Kgo222/ClassroomClarity/README.md

# ClassroomClarity
This project aims to provide portable support for teachers through a central hub that displays student questions submitted through an app while also providing visual queues to inform on student engagement. Our goal is to improve lecture quality for both the students and the teachers by also including a tactile queue for the professor to notify a question as been asked.

Team Members:
- Maddie Donku
- Kaitlin Gowens
- Jesse Gruber

Project Notes are found in the _Notebook_ folder under the _main_ branch.
# Final Design Information
## Physical Design
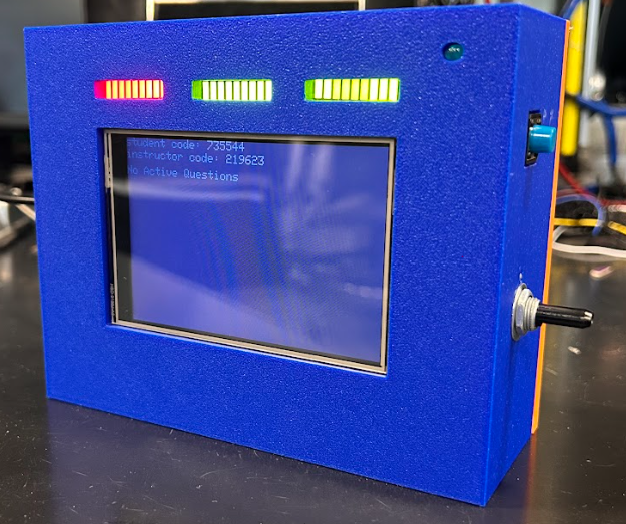
[picture p1: notebooks/kaitlin/finalResults/HubPicture.png]


## Internal Subcircuits
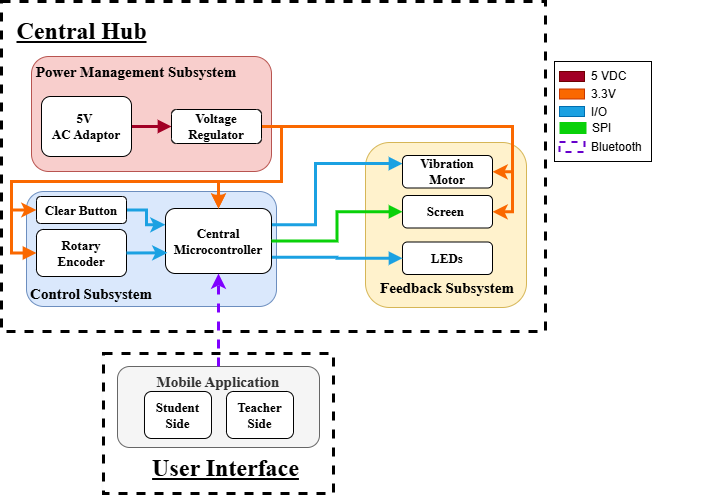
[picture p2: notebooks/kaitlin/finalResults/final_BlockDiagram.png]


## App Layout
### Student
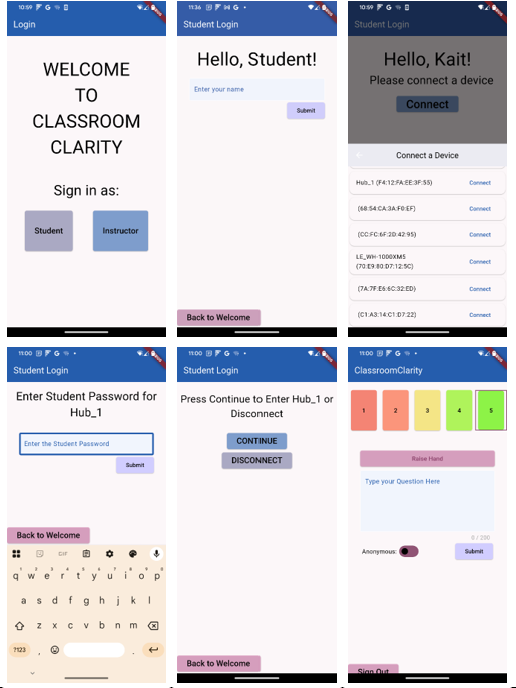
[picture p3: notebooks/kaitlin/finalResults/StudentAppLayout.png]


### Instructor
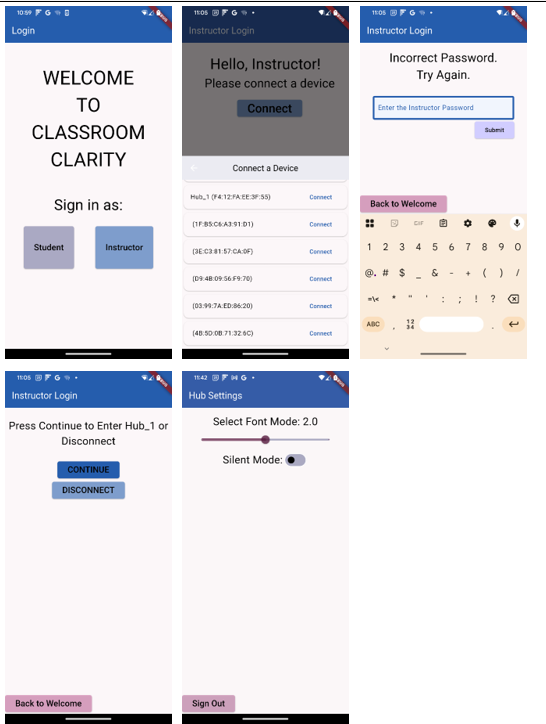
[picture p4: notebooks/kaitlin/finalResults/InstructorAppLayout.png]
