Kgo222/ClassroomClarity/boards/README.md

This folder holds the files concerning PCB design
