Kgo222/ClassroomClarity/notebooks/team/445_initial_brainstorming.pdf

## ece445 lab notebook

# brainstorming

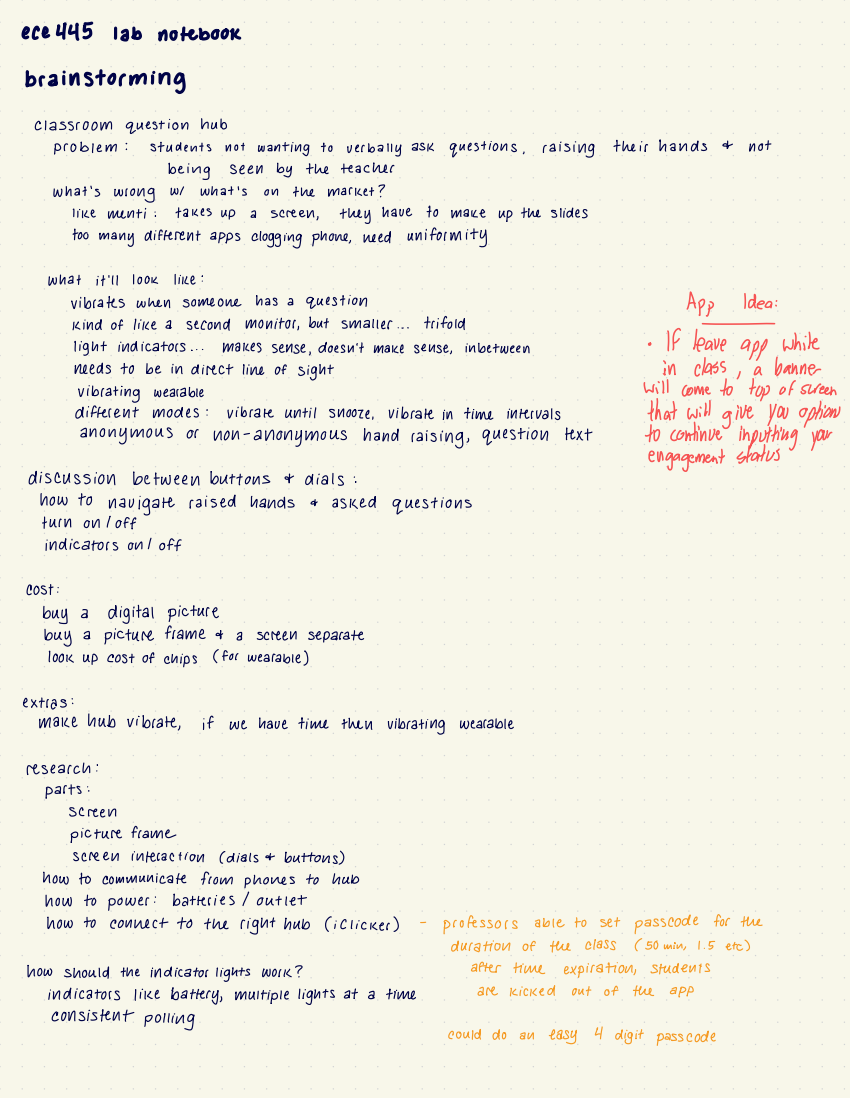
[picture p44: page 1]
classroom; question hub; problem :; students; not; wanting to; verbally ask; questions ,; raising their hands &; being seen; by the teacher; what's wrong we; what's; the; market ?; like; menti :; takes up; screen ,; they have; to make; up the slides; too many different apps clogging phone,; need; uniformity; what; look; like :; vibrates when someone; has a; question; App Idea:; kind of like a; second; monitor,; but smaller ...; trifold; e while light indicators...; makes sense ,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

discussion between buttons & dials :
t un on 1 off
indicators on 1 off

look up cost of chips (for wearable)

how to power: batteries / outlet

Research | Questions
① Bluetooth -> by we | are | making own | microcontroller, | it must

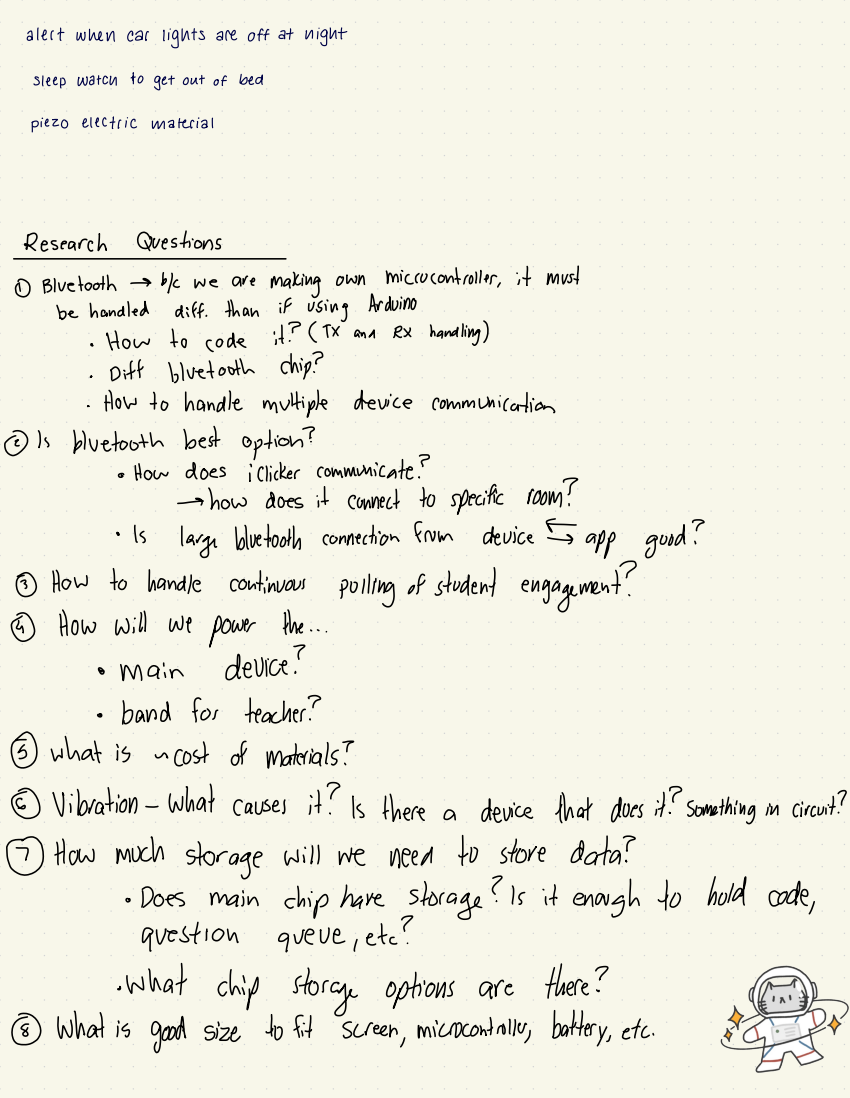
[picture p45: page 2]
alert when car; lights are off at night; sleep watch; to get out of bed; be handled; diff. than if using Ardrino; How to code; it. ? (TX and; handling); bluetooth best option?; How does; iClicker communicate ?; large bluetooth connection from; device to; app good ?; ② How to handle continuous; polling of student engagement?; main; device ?; ⑤ what is; -cost of materials ?; ② Vibration -; what causes; it ? Is there a; device that does it? something in circuit?; & How much storage will we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

piezo electric material

· Diff bluetooth chip?
How to handle multiple device communication

->how does it connect to specific room?

& How will we power the ..

· band for teacher?

I

YA

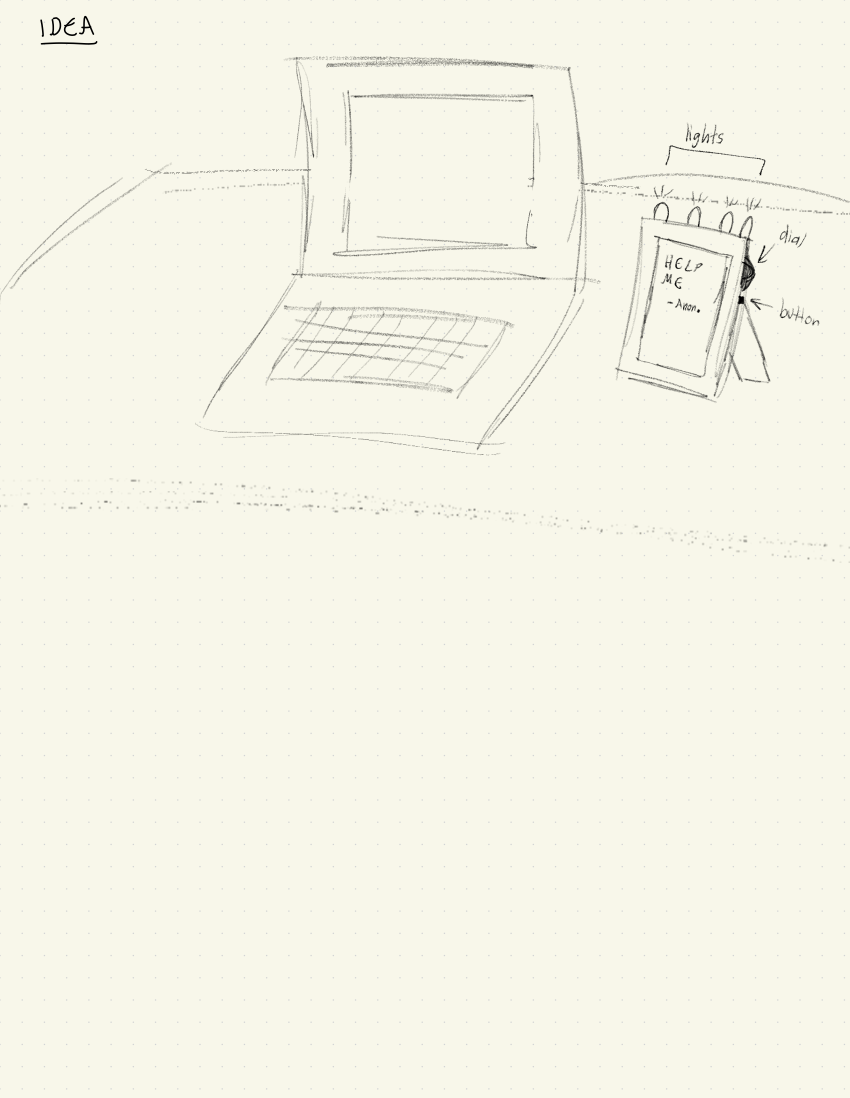
[picture p46: page 3]
