Kgo222/ClassroomClarity/notebooks/jesse/week_of_4_6_2025/445_WO_4_6_2025.pdf

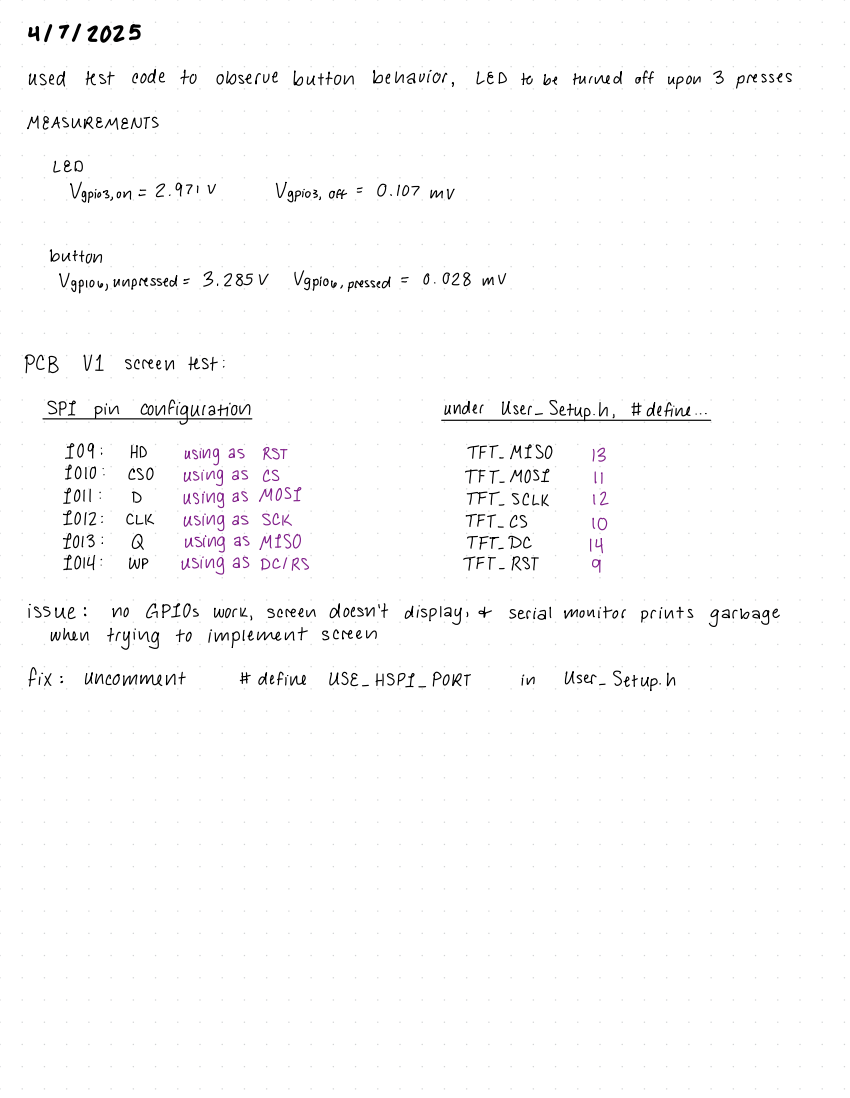
[picture p47: page 1]
used; test code to; observe button behavior ,; LED to be; turned off upon 3 presses; MEASUREMENTS; LED; Vapios, on =; Vapios,; off =; button; Vypion, unpressed =; Vypion ,; pressed =; PCB; screen; test :; SP1 pin; configuration; under; User-Setup.; #define....; using as; RST; TFT_; CSO; MOSI; using as MOSI; SCLK; CLK; SCK; TFT-; using as MISO; using as DC/RS; TFT-RST; issue :; GP10s work ,; doesn't display ,; serial monitor prints garbage; when; trying to; implement screen; fix :; Uncomment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

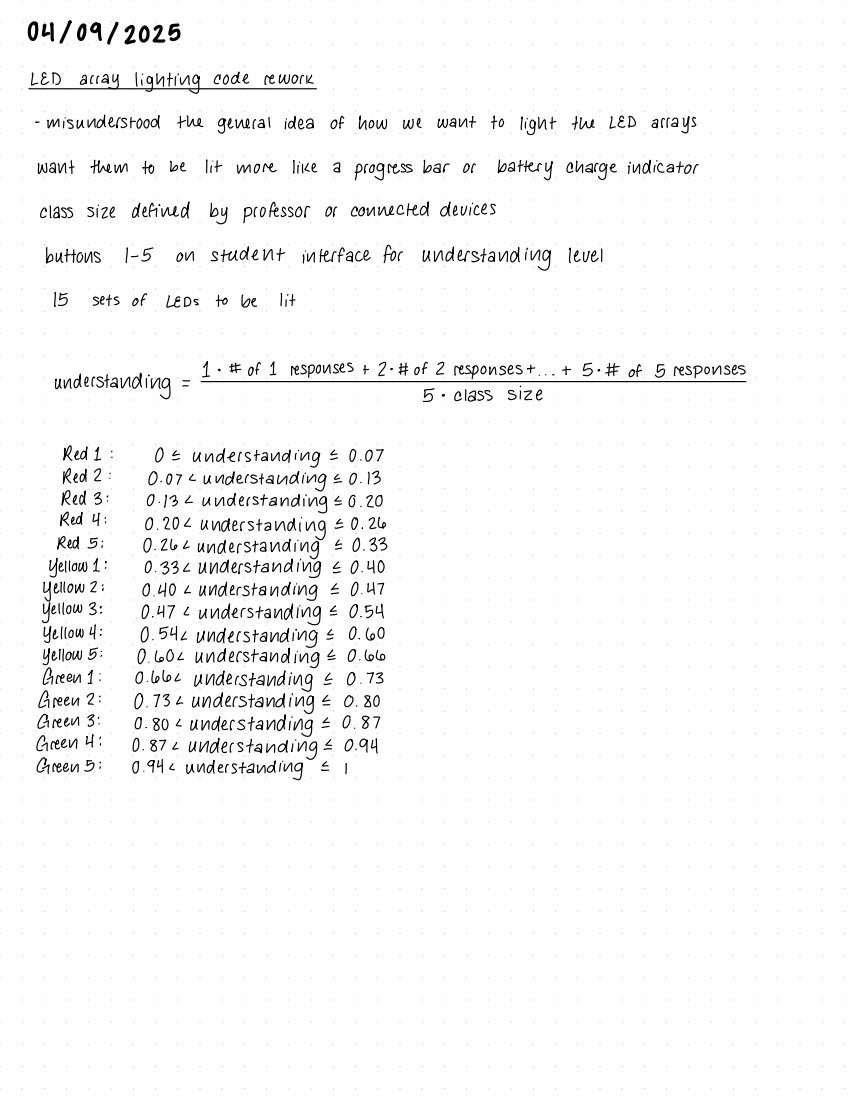
[picture p48: page 2]
LED; array lighting code rework; -misunderstood the general idea of how we; want to light the LED arrays; want them to be; lit more; like a; progress bar or; battery charge indicator; class size defined by professor or; connected devices; buttons; student interface for understanding level; sets of; LEDs; lit; # of 1 responses + 2 ·; # of 2 responses +... +; # of 5 responses; understanding =; class size; Red 1 :; understanding = 0 .; Red 2 :; 07 understanding = 0 .; Red 3 :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

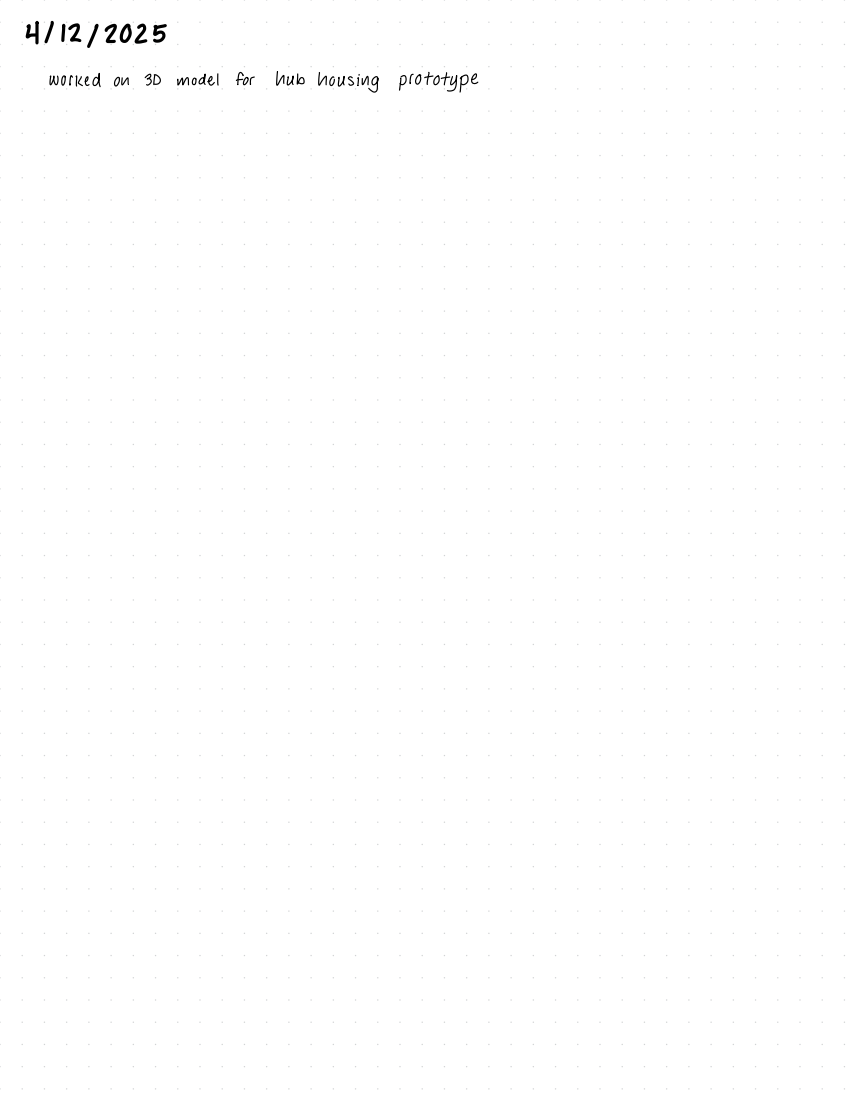
[picture p49: page 3]
worked on; model; for; hub housing prototype
