Kgo222/ClassroomClarity/notebooks/jesse/week_of_3_30_2025/445_WO_3_30_2025.pdf

processing for class | understanding data to | LEDs

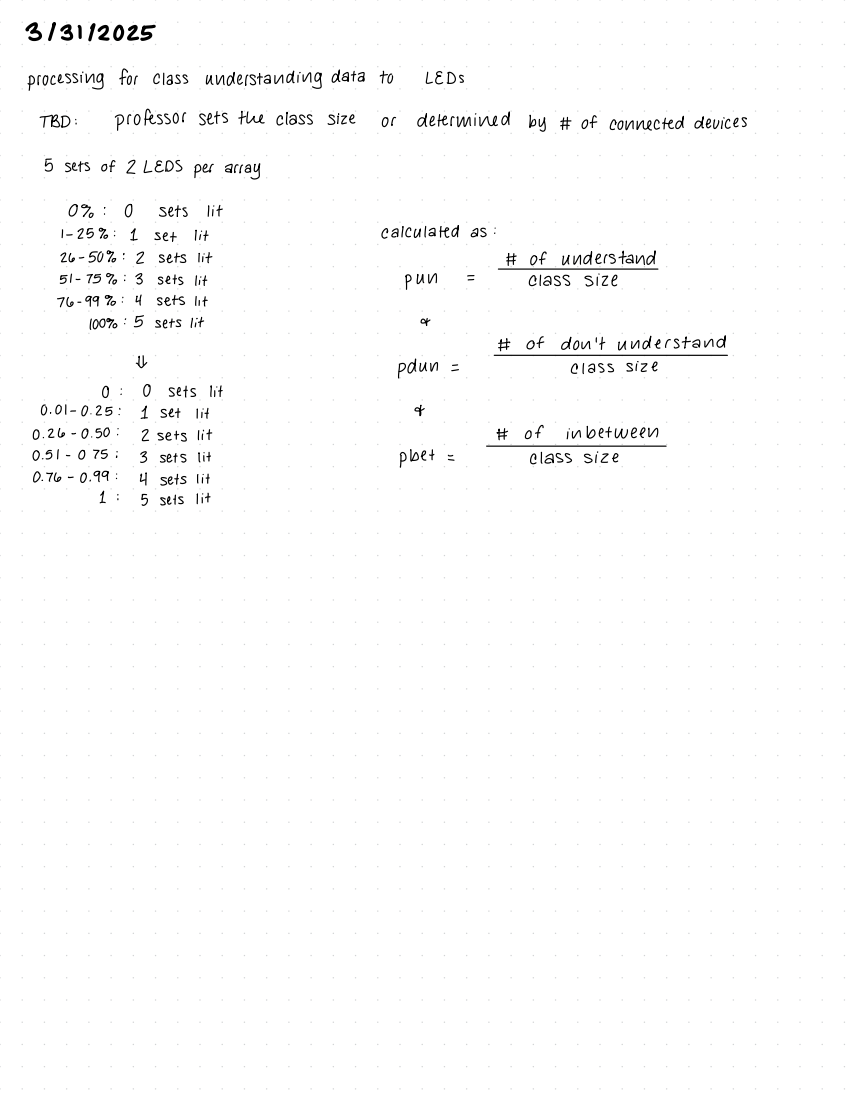
[picture p50: page 1]
TBD :; professor sets the class size; determined by # of connected devices; Sets; lit; calculated as : 1-25 %:; set; 26-50 %: I sets lit; # of understand; sets lit; pun; class size; 100%: 5 sets lit; don't understand; poun =; Class size; Sets lit; 1 set; I sets lit; inbetween; 3 sets; plet =; 4 sets lit; 5 sets lit

5 Sets of 2 LEDS per array

We | successfully communicated | with the | chip

## used the programming buttons

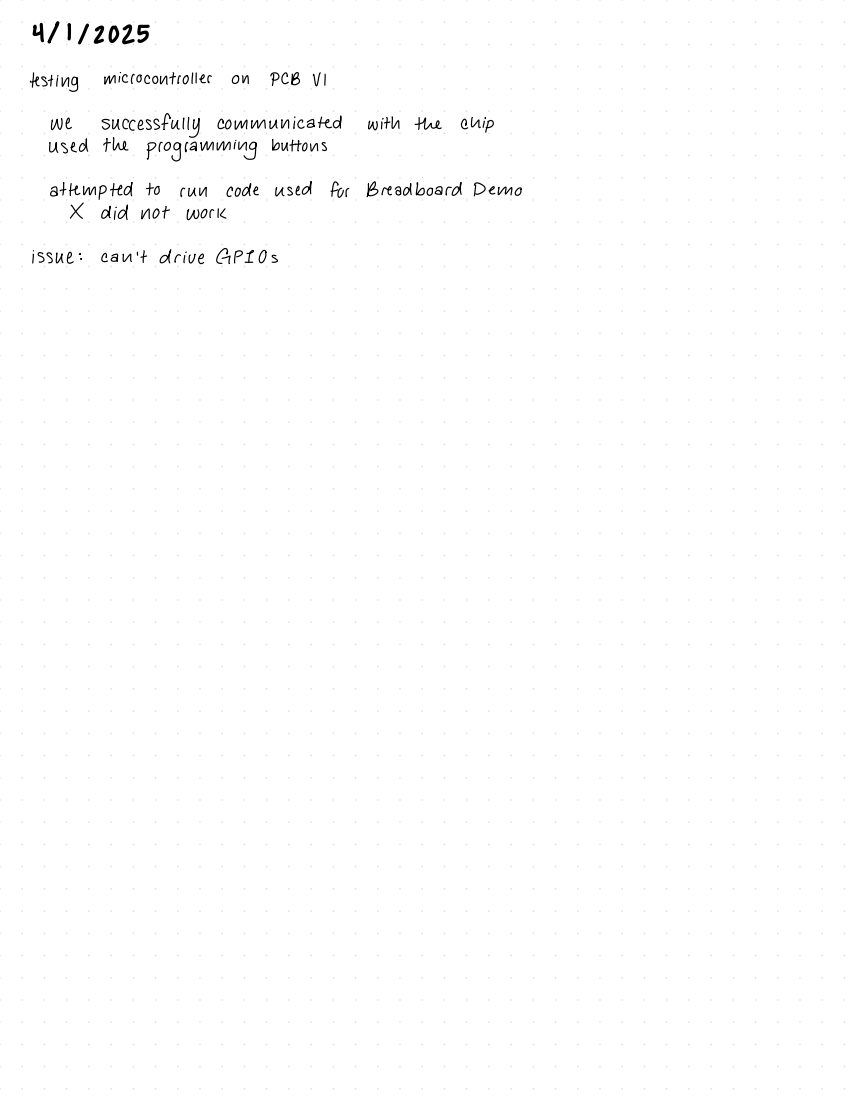
[picture p51: page 2]
testing; microcontroller; PCB VI; attempted to; run; code used for Breadboard Demo; issue :; can't drive GPIOs

X did not work

## testing w/ PCB VI

### esolved GPIO driving issue :

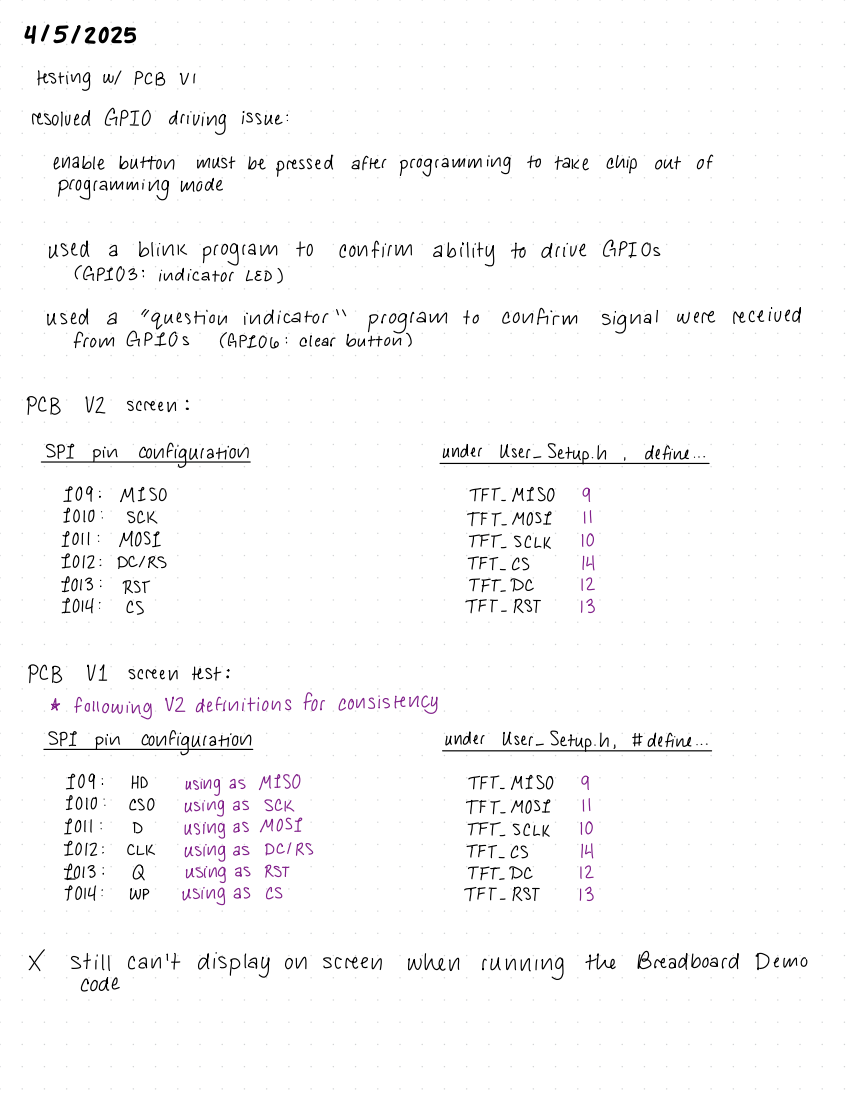
[picture p52: page 3]
enable button; must be pressed after programming to take chip out of; programming mode; used a; blink program to; confirm ability to drive GPIOs; CGP103 :; indicator LED); "question indicator"; program to; confirm; signal were; received; from GPIOs; clear button (; PCB; VI screen :; SP1 pin; configuration; under; User-Setup.; define....; MISO; TFT_; SCK; MOSI; SCLK; TFT-; RST; TFT-RST; screen; test :; #define....; using as; CSO; a using as; using as MOSI; CLK; X still can't display on; when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

* following V2 definitions for consistency
