Kgo222/ClassroomClarity/notebooks/jesse/week_of_3_23_2025/445_WO_3_23_2025.pdf

3/23/2025

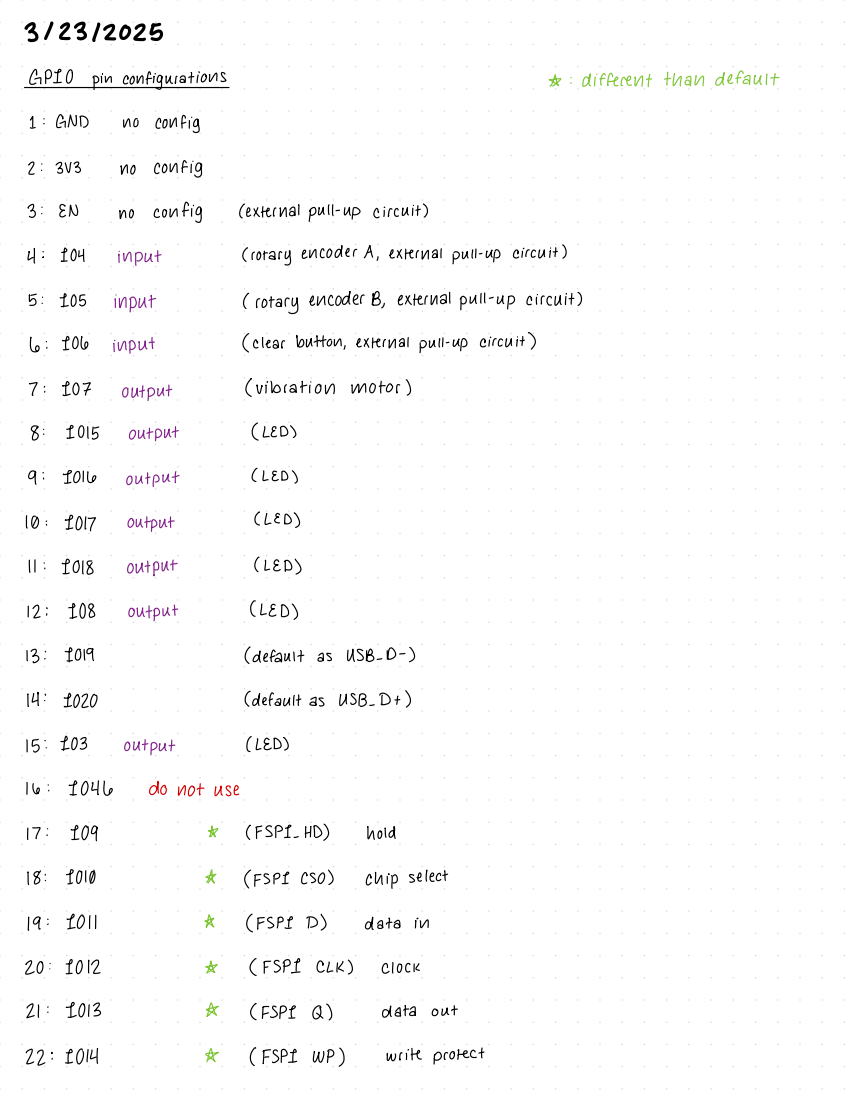
[picture p53: page 1]
GPIO pin configurations; *: different than default; GND; config; (external pull-up circuit); Crotary encoder A ,; external pull-up circuit 4 :; input; (rotary encoder B,; external pull-up circuit; (clear button,; external pull-up circuit) input; (vibration motor) output; output; (LED); (default as; USB-D-; USB-D +); do not use; (FSP1 -; hold; (FSP1 CSO); chip select; (FSP1 D); data in; (FSP1 CLK); Clock; CESPEQ); data out; (FSP1 WP); write protect

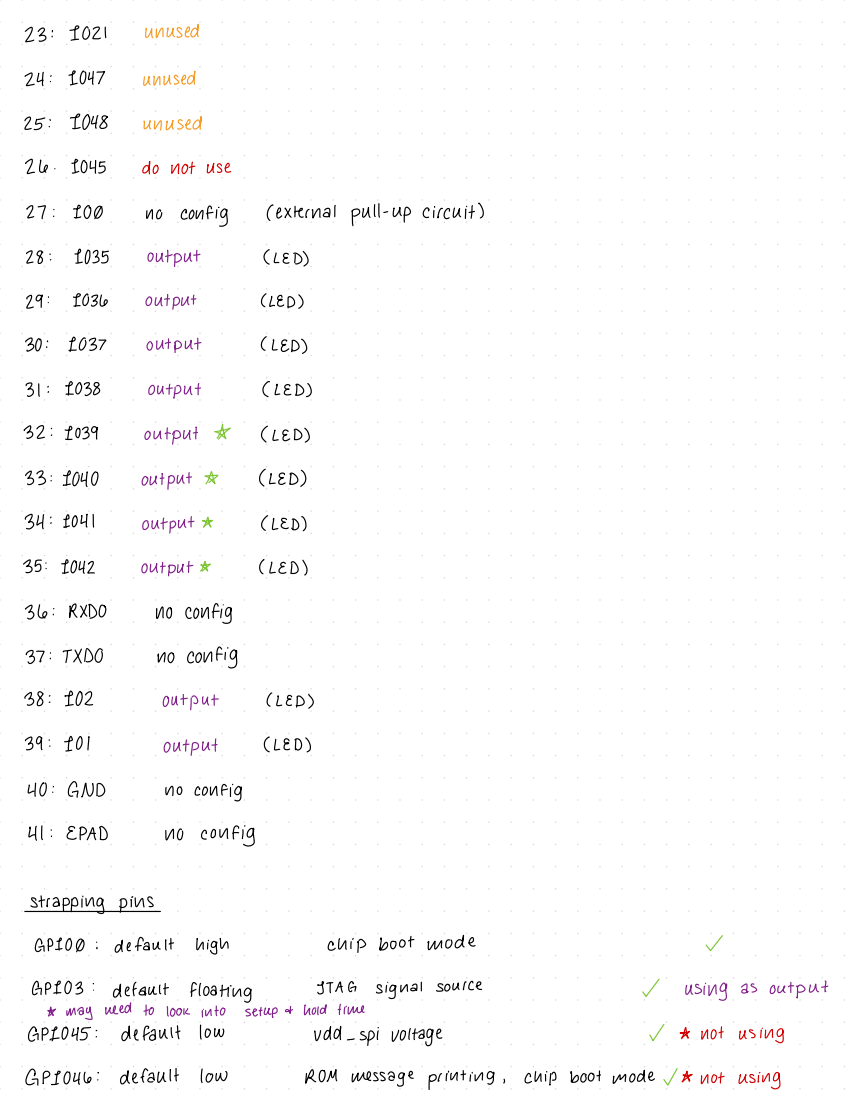
[picture p54: page 2]
unused; do not use; config; (external pull-up circuit; output; (LED); output A; outputA; RXDO; no config; TXDO; GND; EPAD; strapping pins; default; high; chip boot mode; ITAG; signal source; using as output floating * may need to look into; setup a; hold time; default low; udd _; spi voltage; * not using; low; ROM message printing ,; chip boot modeAnot using
