Kgo222/ClassroomClarity/notebooks/jesse/week_of_3_2_2025/445_WO_3_2_2025.pdf

03/08/2025

## Rotary encoder functionality test

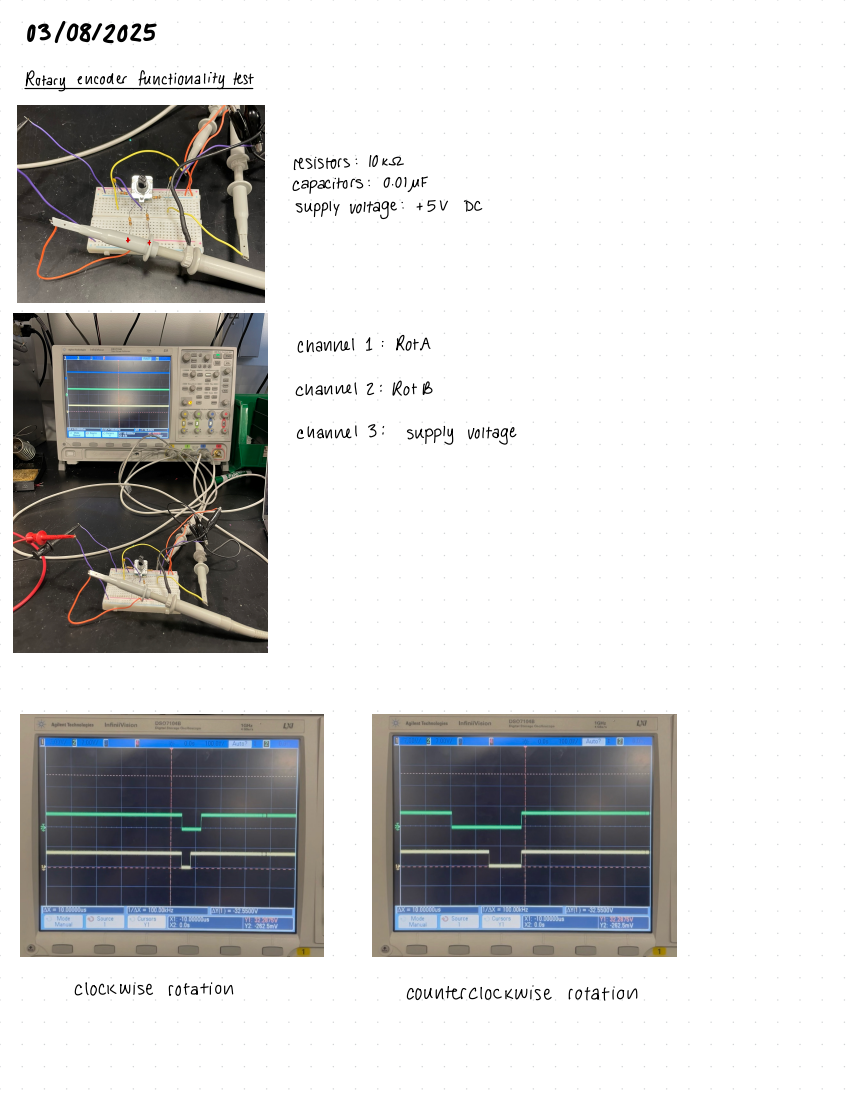
[picture p55: page 1]
resistors :; capacitors :; OIMF; supply voltage :; Channel 1 :; RotA; Channel 2 :; Rot B; channel 3 :; supply voltage; Clockwise rotation; counterclockwise rotation

set | interrupt | on | RotB GPIO
if A = 1 | & | B = | 1 , | no | change

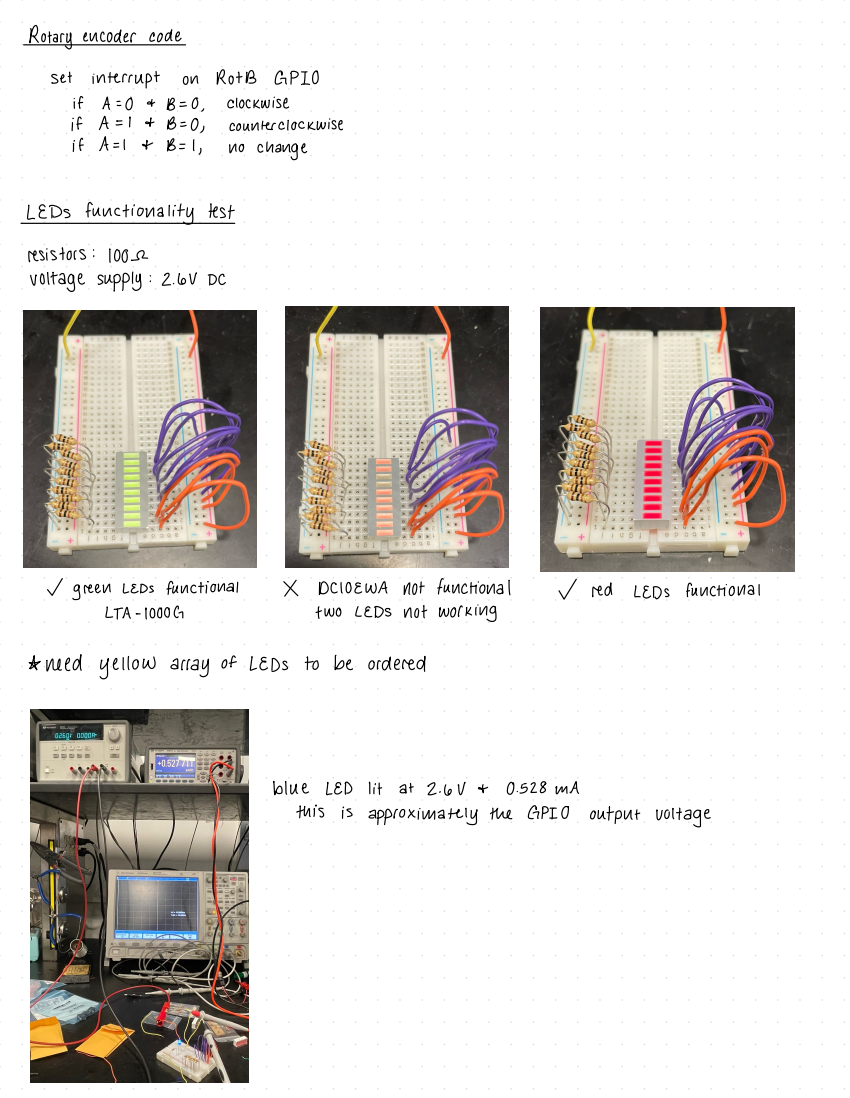
[picture p56: page 2]
clockwise; counterclockwise; resistors :; voltage supply :; green LEDs; functional; DCIOEWA not functional; red; LEDs functional; LTA-1000G; two LEDs not working; blue LED lit; this; approximately the; GPIO; output voltage

Rotary encoder code

LEDs functionality test

* need yellow array of LEDs to be ordered
