Kgo222/ClassroomClarity/notebooks/jesse/week_of_2_9_2025/445_WO_2_9_2025.pdf

Red | Yellow | | Green
1 | 1 | I | 1

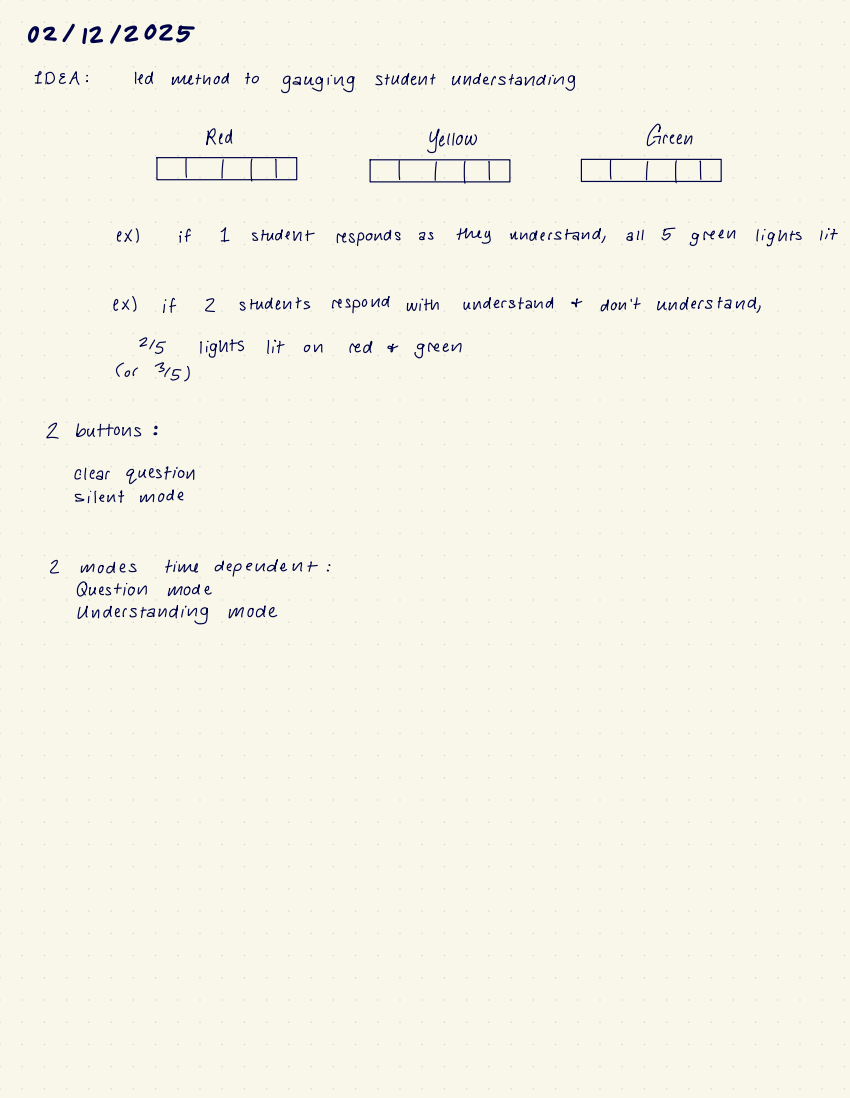
[picture p57: page 1]
IDEA :; led; method; gauging student; understanding; student; responds as; they; understand,; all; 5 green; lights lit; students; respond with; understand a; don't; understand ,; lights; lit; red; green; Cor; 2 buttons :; clear; question; Silent mode; modes; time; dependent :; Question; mode; Understanding mode
