Kgo222/ClassroomClarity/notebooks/maddie/Breadboard set up.pdf

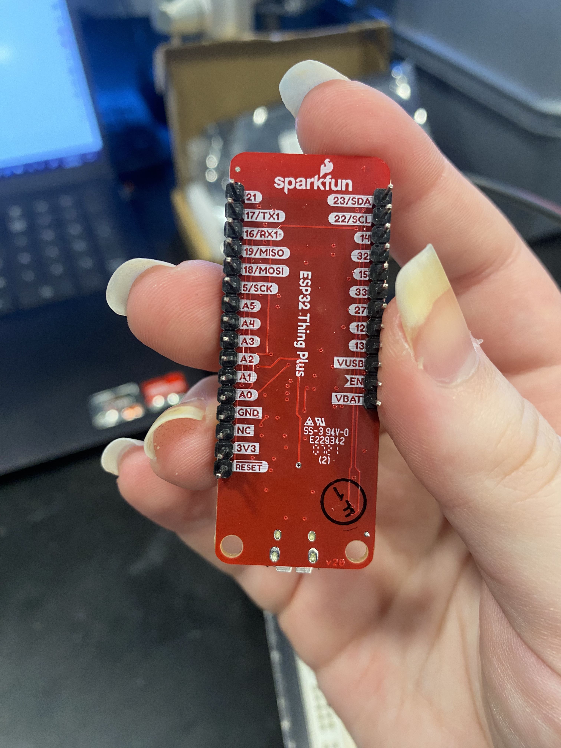
[picture p58: page 1]
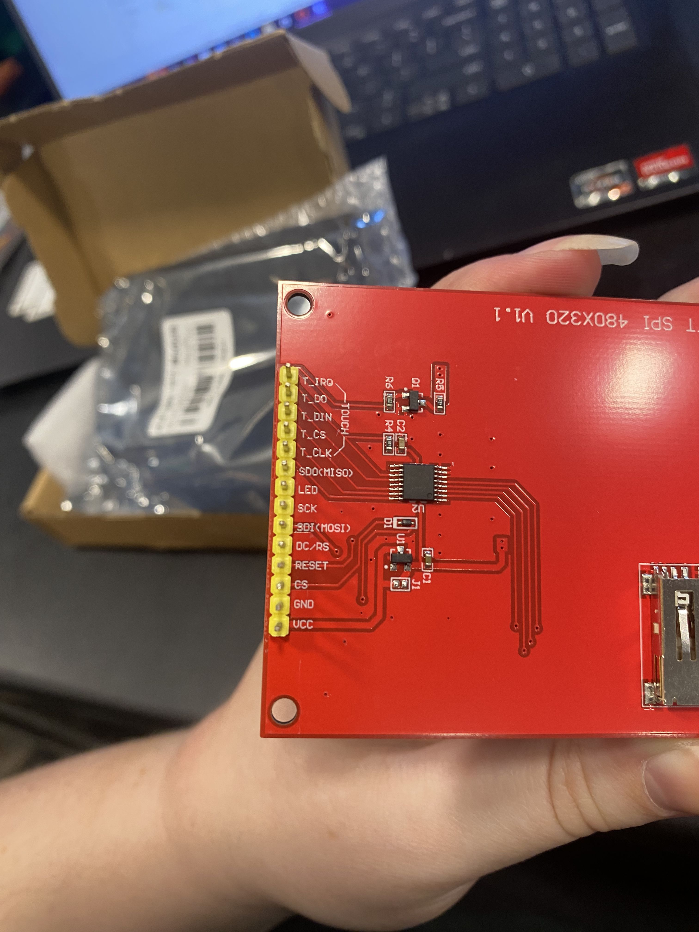
[picture p59: page 2]
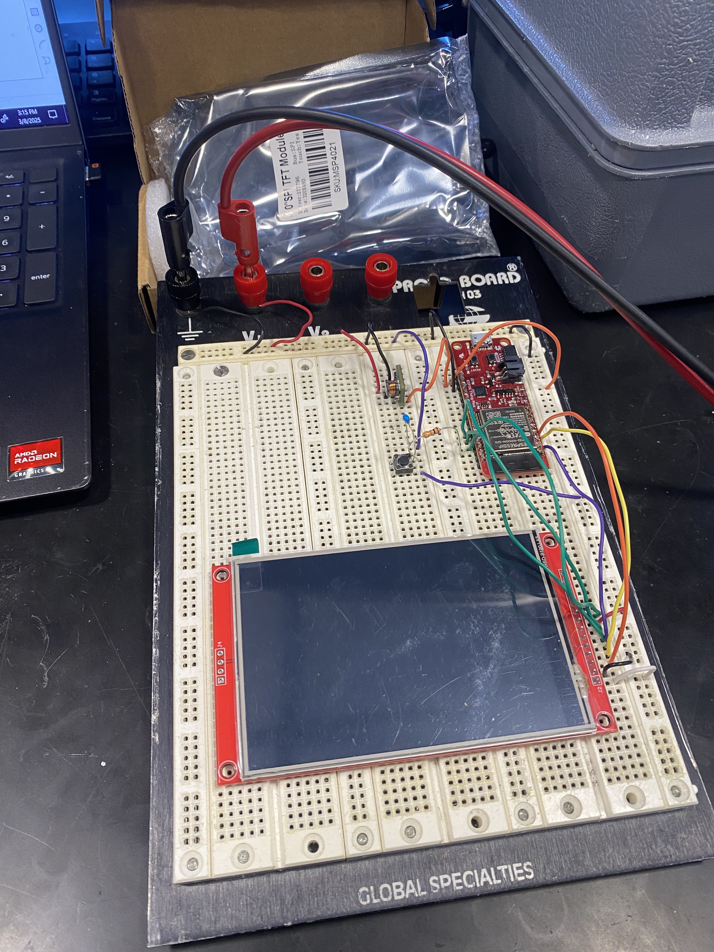
[picture p60: page 3]
