Kgo222/ClassroomClarity/notebooks/maddie/Power Subsystem Schematic.PNG

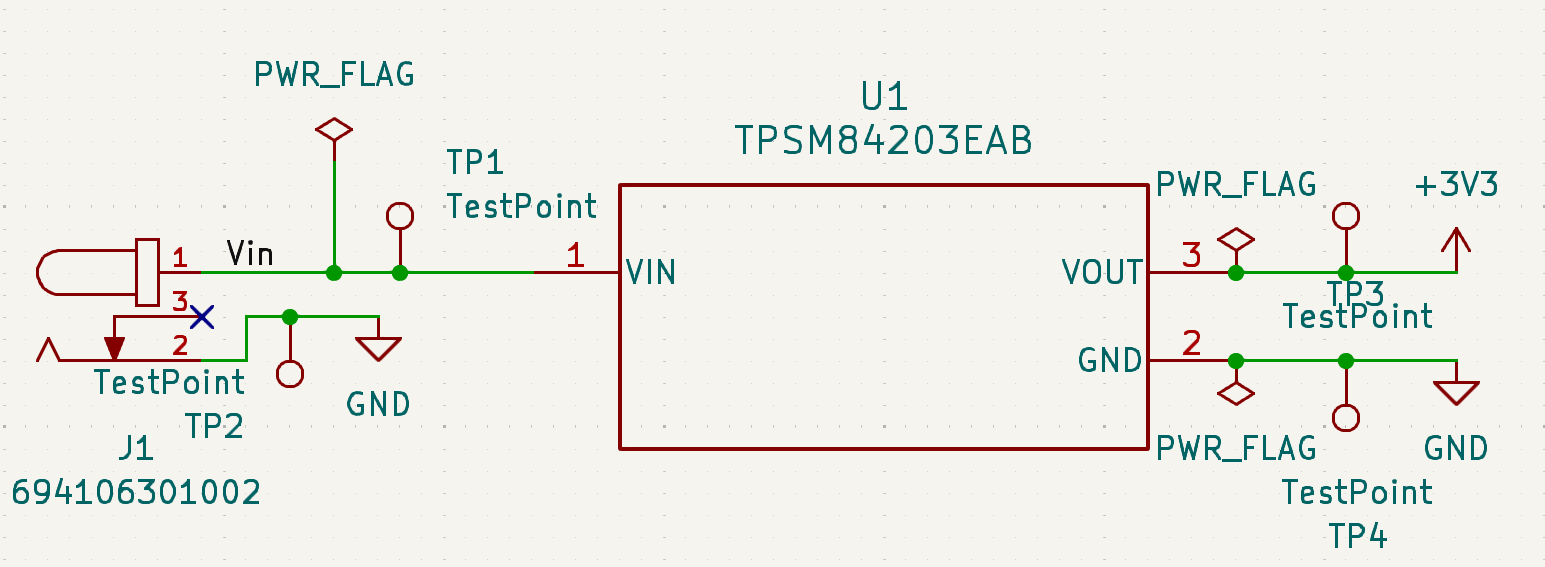
notebooks/maddie/Power Subsystem Schematic.PNG
