Kgo222/ClassroomClarity/notebooks/jesse/ClassroomClarity_Final.stl

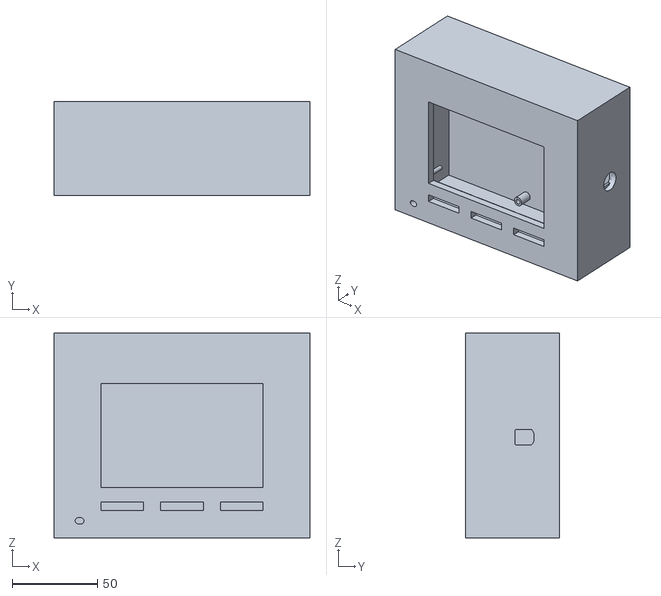
[picture p62: CAD file, 2025-05-08]
notebooks/jesse/ClassroomClarity_Final.stl
150.0 x 55.0 x 120.0
