Kgo222/ClassroomClarity/notebooks/maddie/PowerVerification3Test.pdf

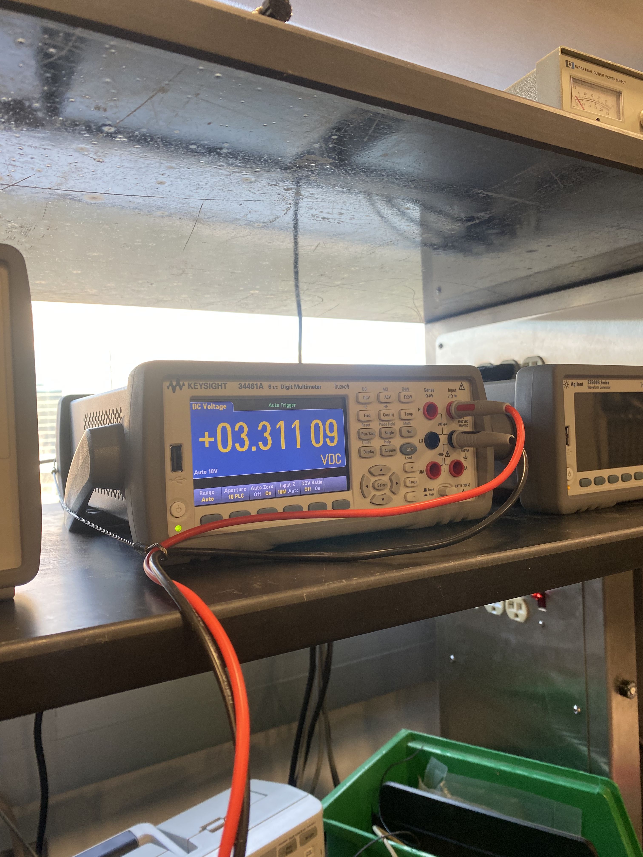
[picture p63: page 1]
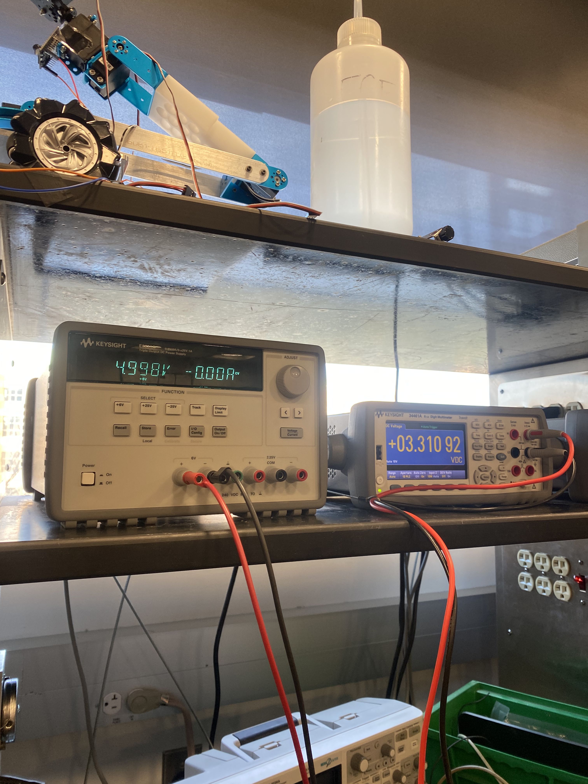
[picture p64: page 2]
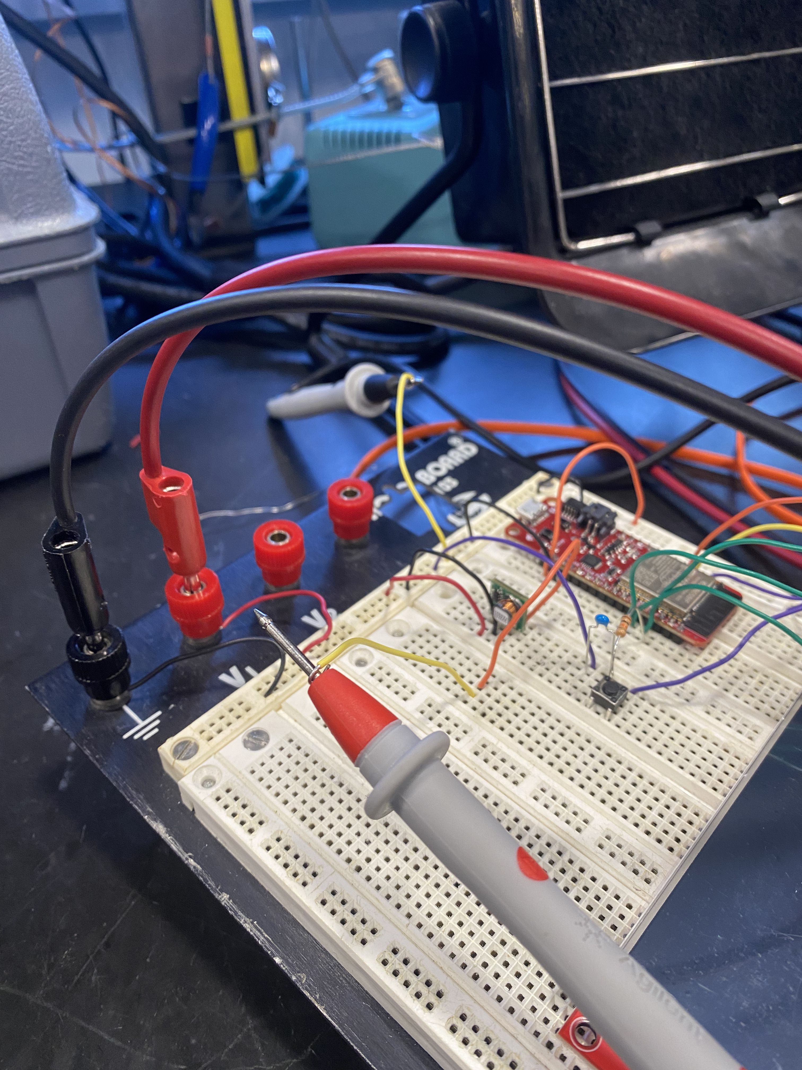
[picture p65: page 3]
