Kgo222/ClassroomClarity/notebooks/kaitlin/DesignRefs/App Design .pdf

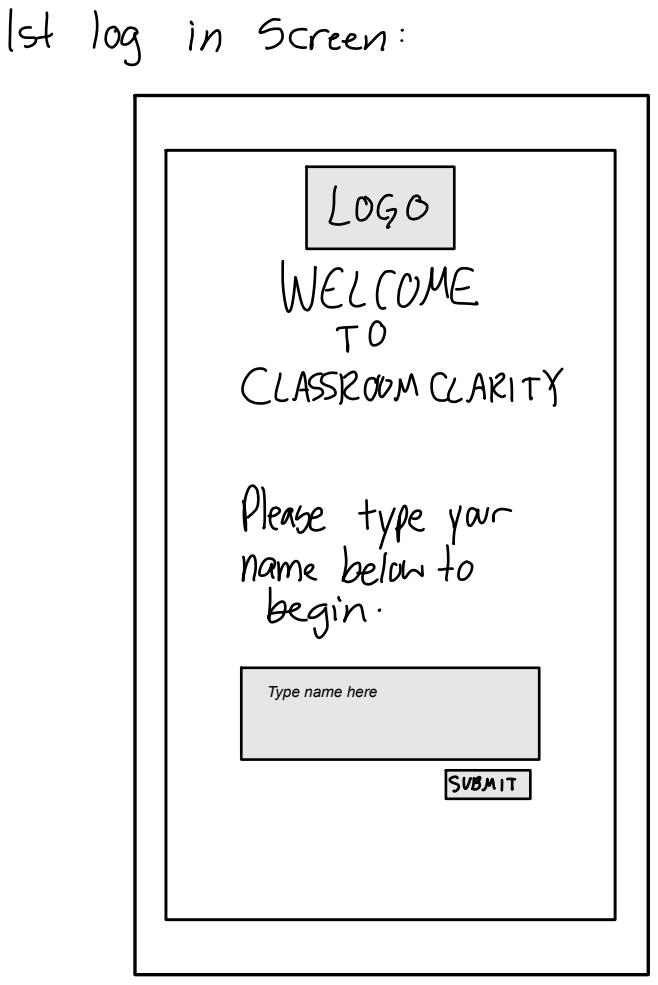
[picture p66: page 1]

Type name here

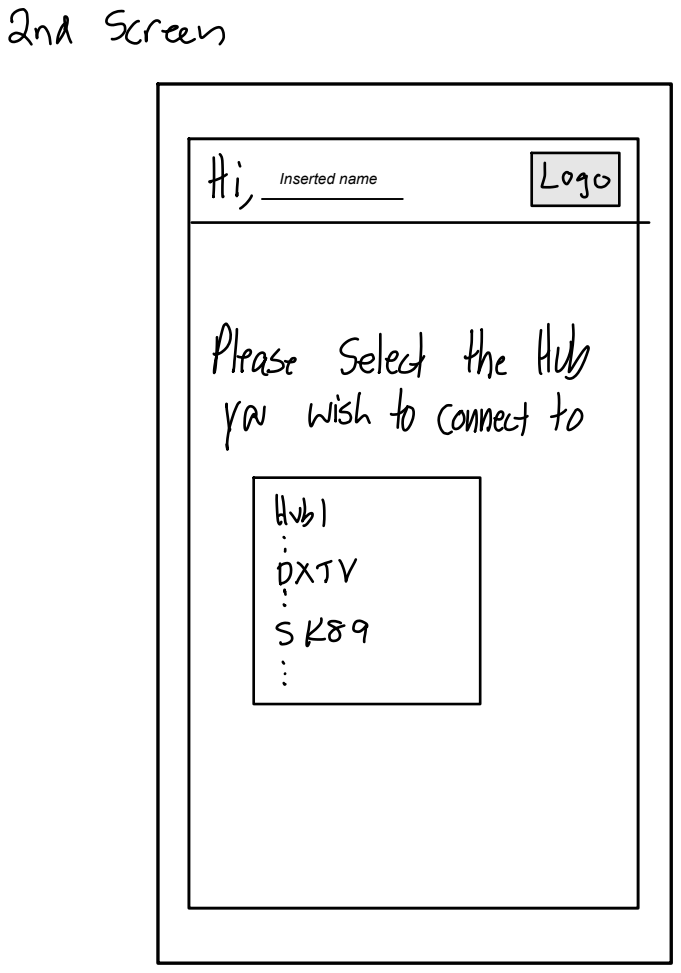
[picture p67: page 2]
Inserted name

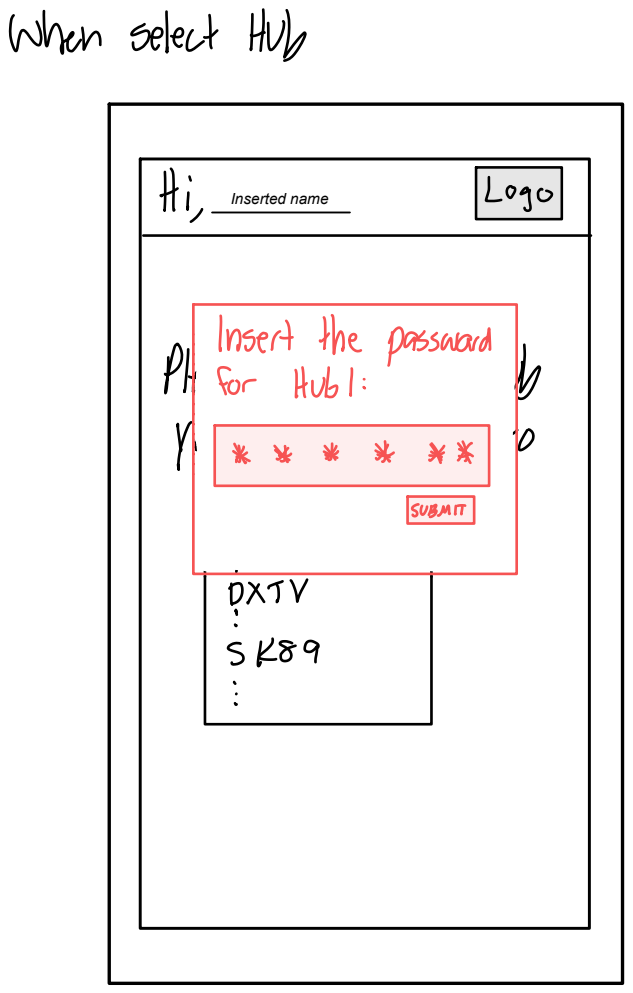
[picture p68: page 3]
Inserted name

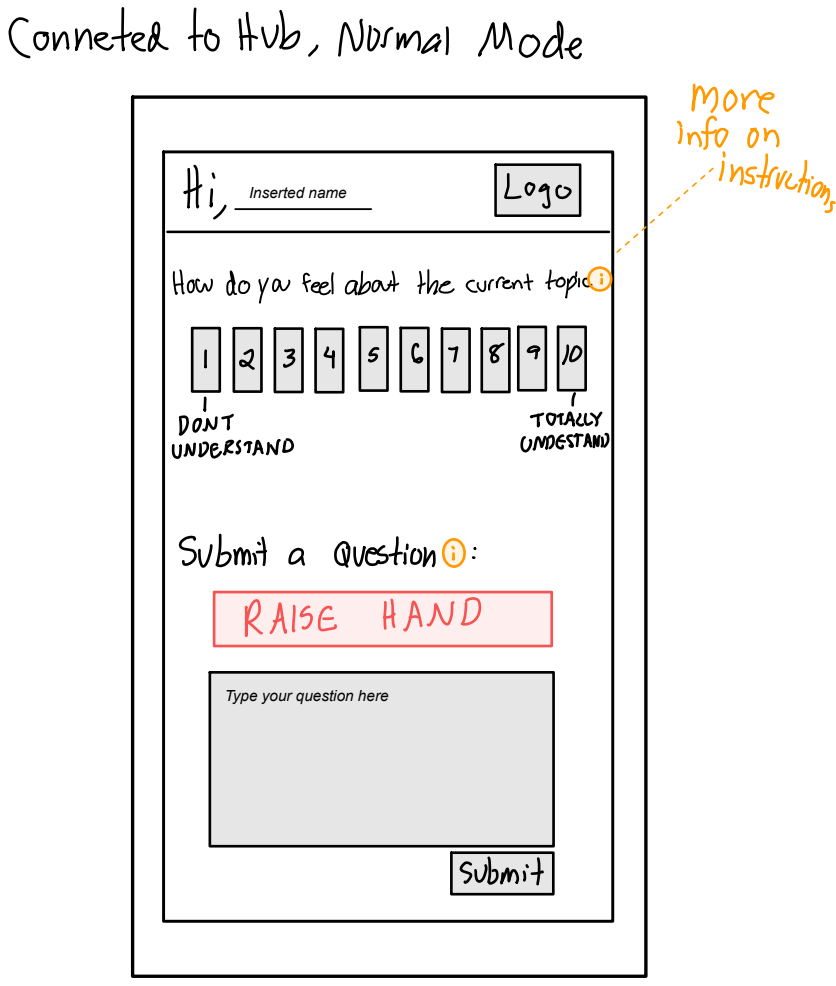
[picture p69: page 4]
Inserted name

Type your question here

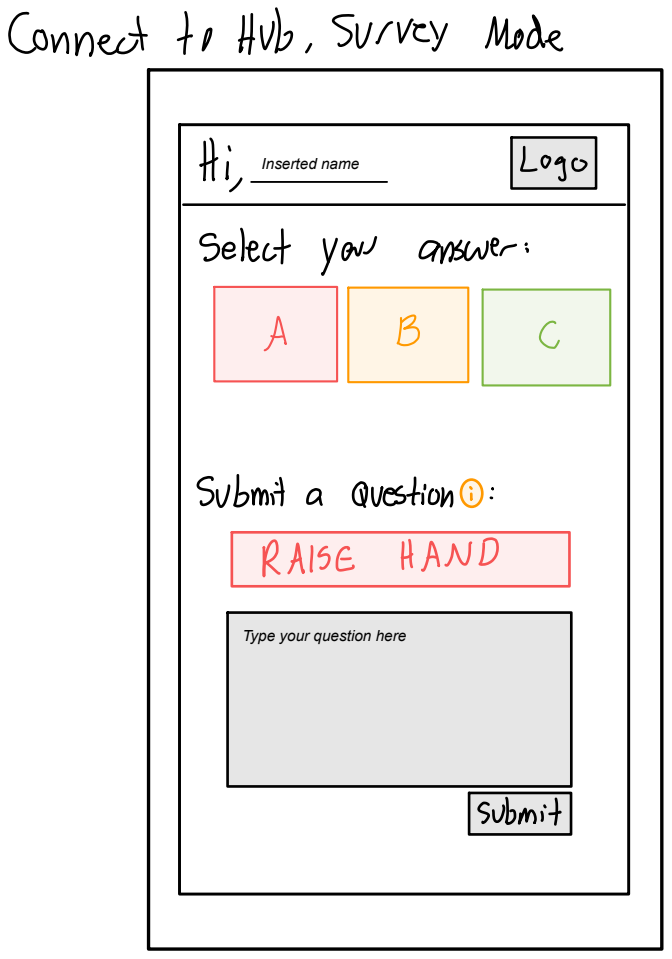
[picture p70: page 5]
Inserted name

Type your question here
