Kgo222/ClassroomClarity/notebooks/maddie/ECE 445- Vibration motor and BJT.pdf

Vibration | Motor | 2)27/2025
Requirements | 2.

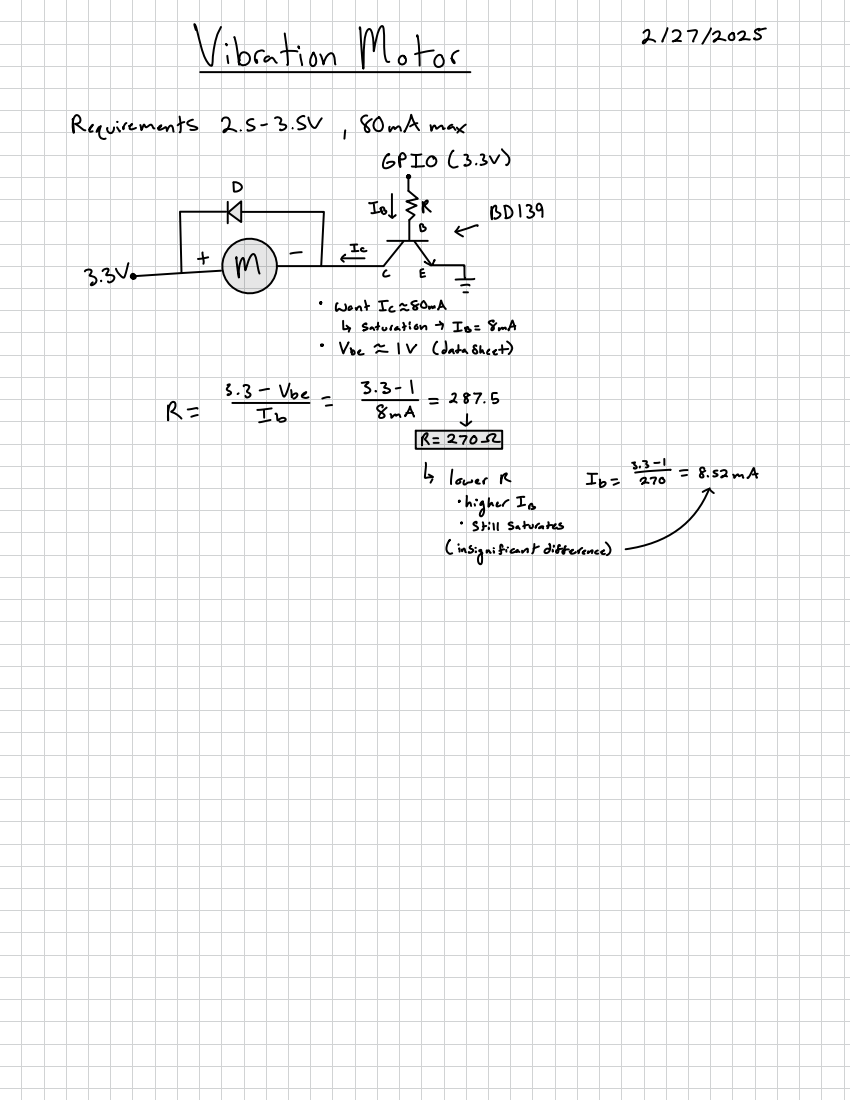
[picture p71: page 1]
max; GPIO; Want; Saturation -; SmA; Voe = IV; (data Sheet]; Ube; lower; higher Is; Still Saturates Linsignificant difference)
