Kgo222/ClassroomClarity/notebooks/maddie/Physical Casing ideas.pdf

Physical | Casing | -
screen | -

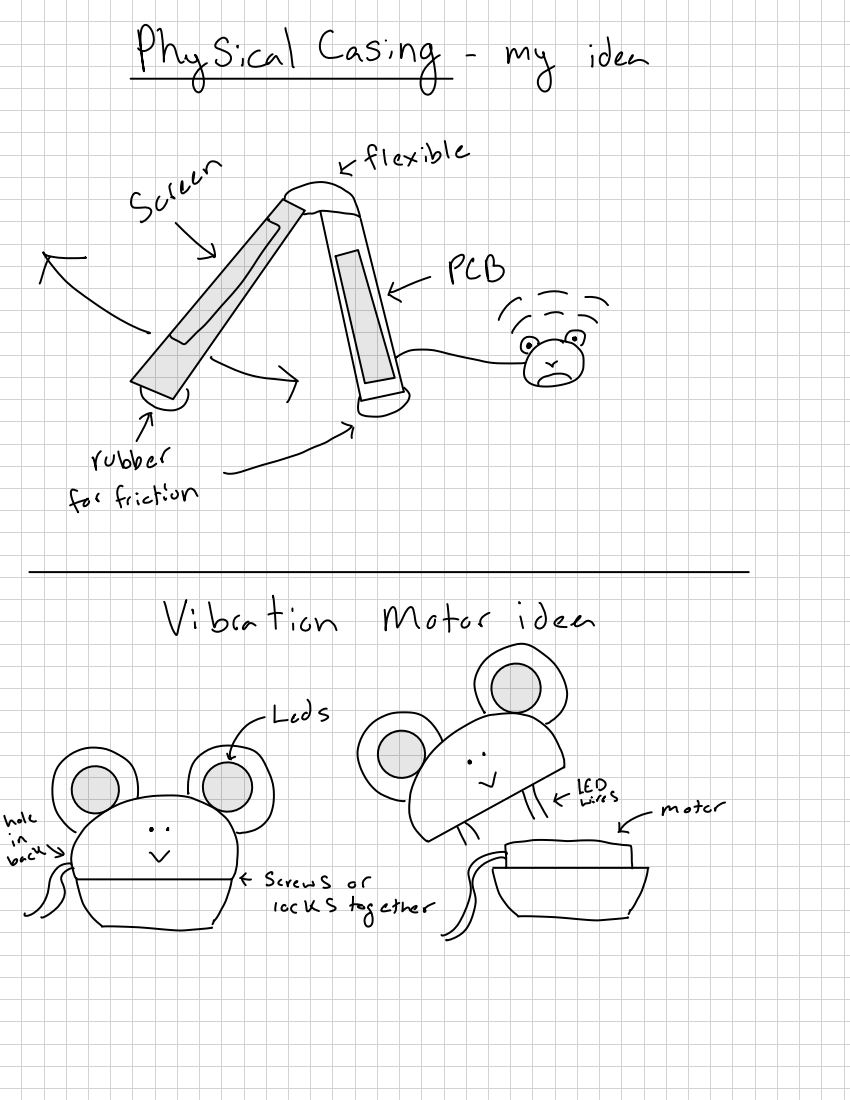
[picture p72: page 1]
idea; flexible; PCB; rubber; for; friction; Vibration; Motor; Clwas C motor; hole; k-= ***garner
