Kgo222/ClassroomClarity/notebooks/jesse/week_of_4_13_2025/445_WO_4_13_2025.pdf

4/15/2025

## working on housing refinements

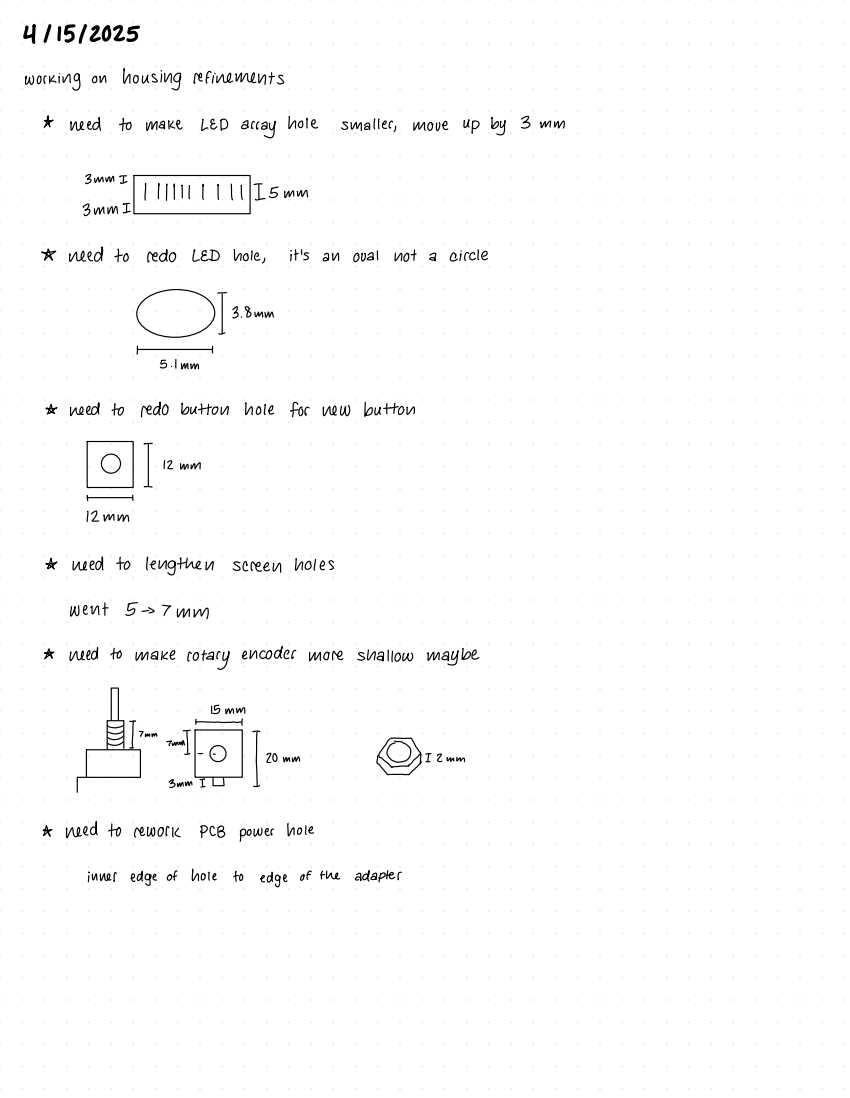
[picture p73: page 1]
need; to make; LED array hole; smaller,; more; * need to; redo LED hole,; oval; not a; circle; Imm; redo button; hole for new button; need to lengthen screen holes; went 5-7 mm; need to make rotary encoder more; shallow maybe; Emm; EFocul--; Frommzn; * need to rework; PCB power hole; inner; edge of; hole; edge of the; adapter

4/18/2025

# I3mm

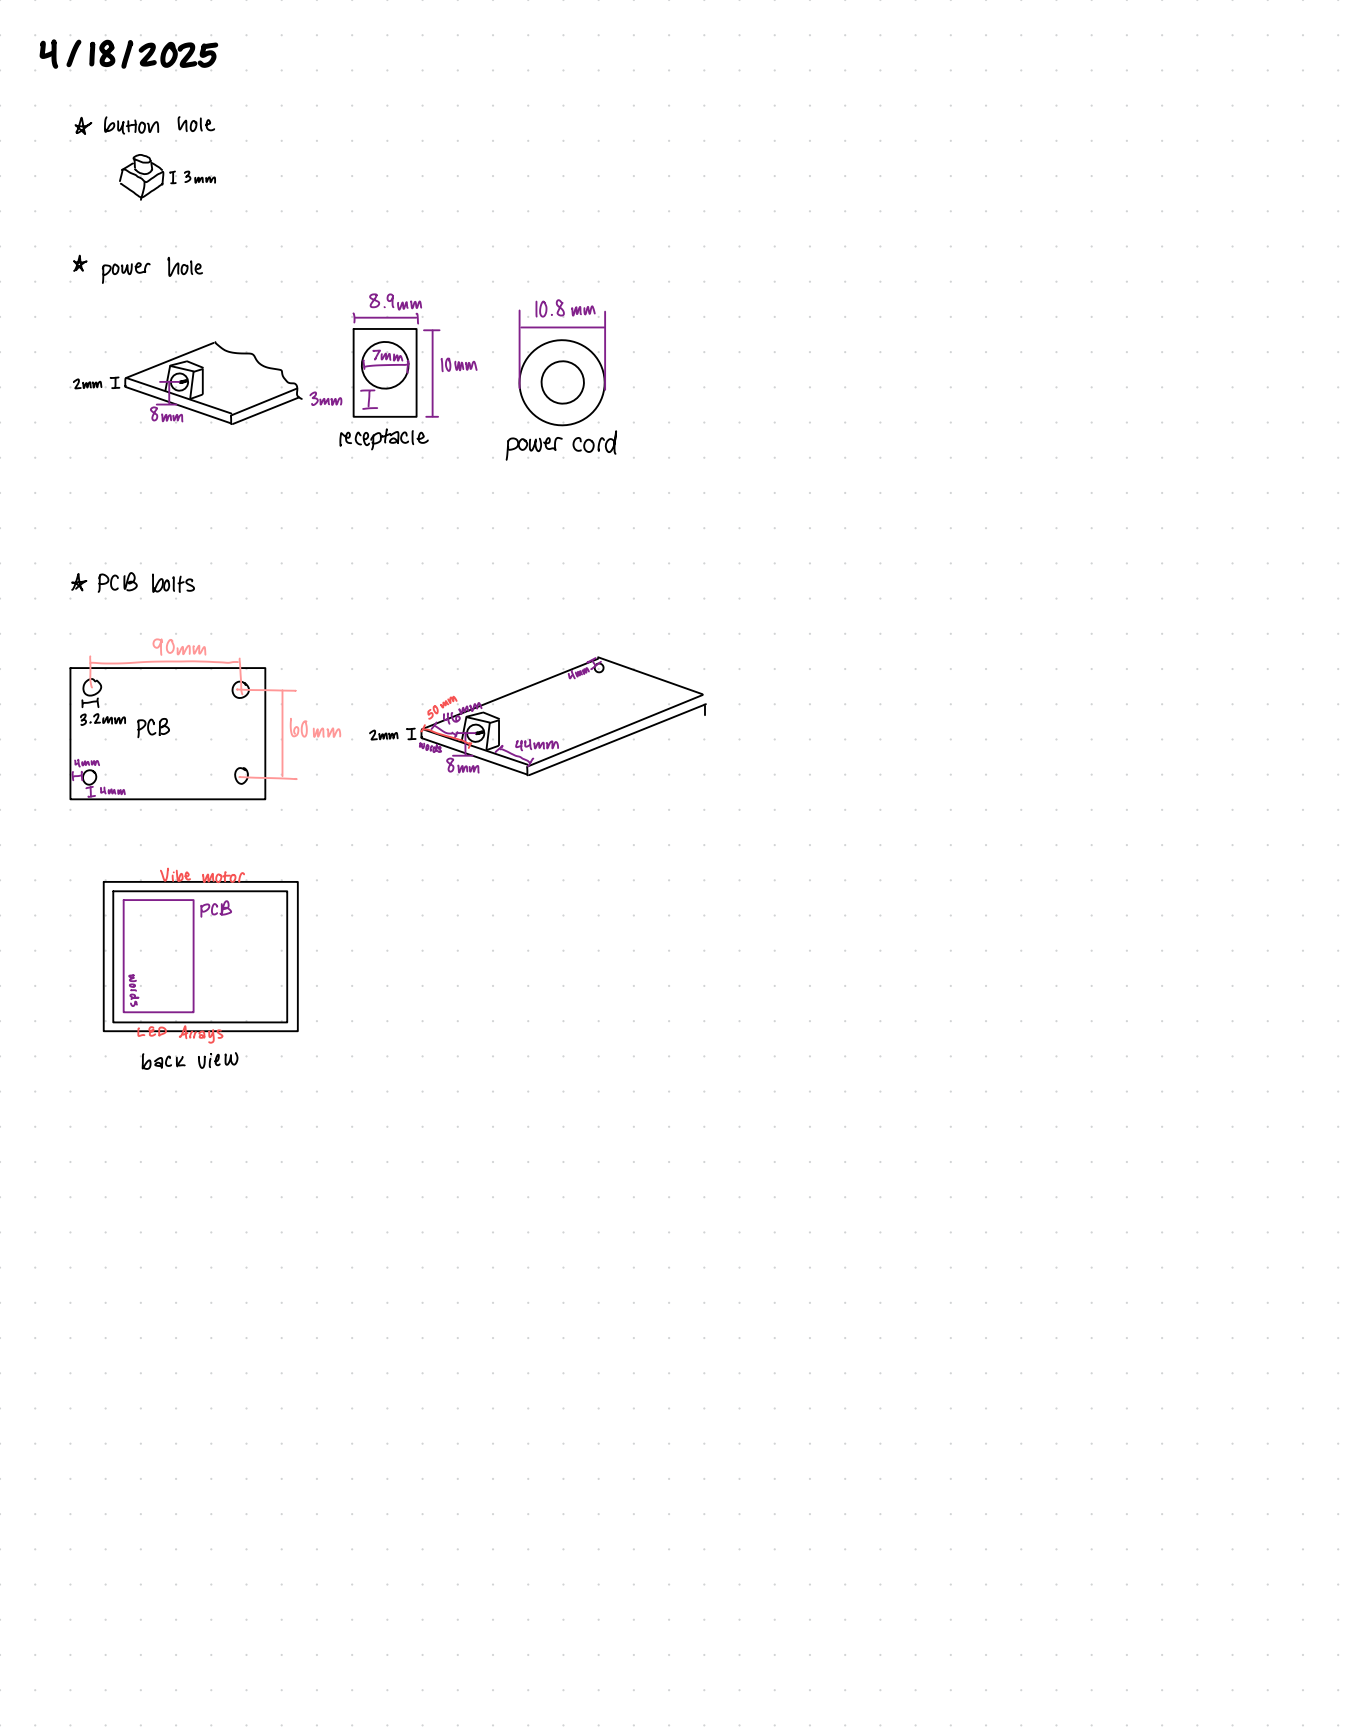
[picture p74: page 2]
* button hole; power hole; Imm Il; Tmm; receptacle; power cord; * PCB bolts; gomm; umm[; 3 .2 mm pCB; 2mm ImmmE; words; umm; Humm; Vibe motor; PCB; LED Arrays; back view
