Kgo222/ClassroomClarity/notebooks/jesse/week_of_2_23_2025/445_WO_2_23_2025.pdf

# Team meeting 2/26/2025

*

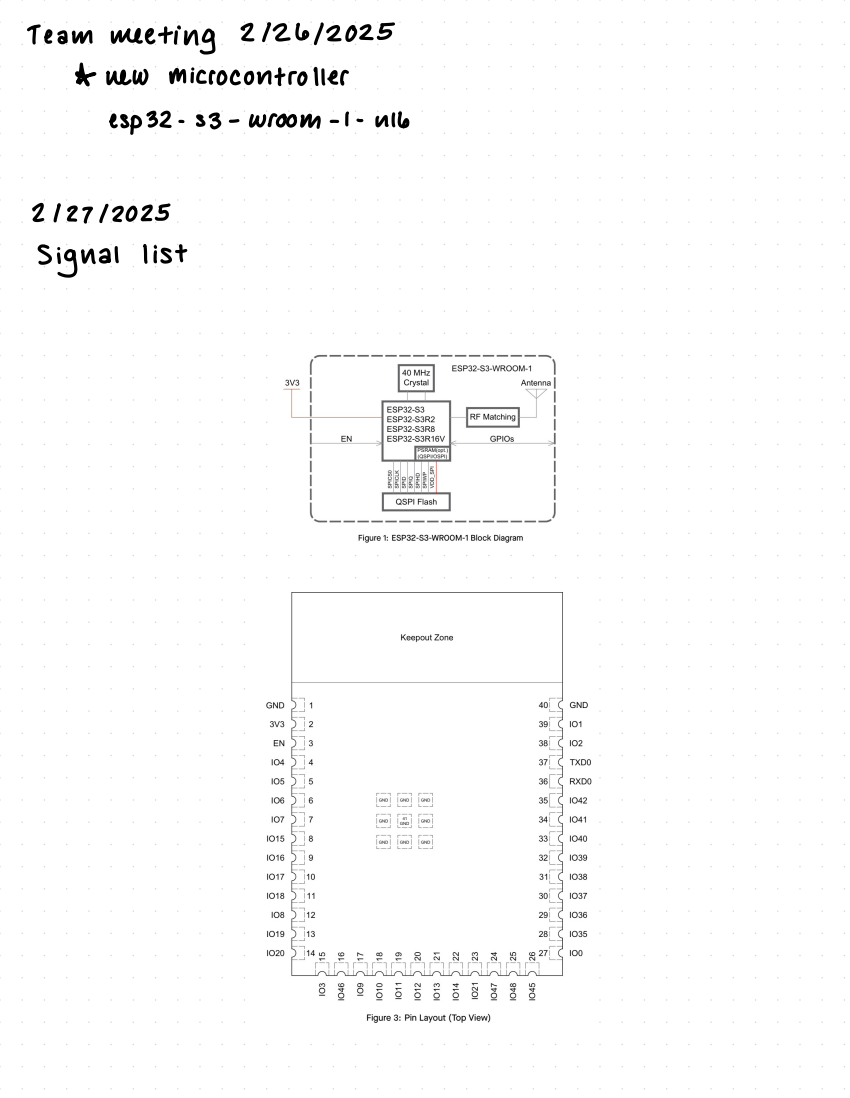
[picture p75: page 1]
new microcontroller; esp32-s3-wroom-1-ull; 2/27/2025 Signal list

used for programming | screen | leds

### >button/RC circuit

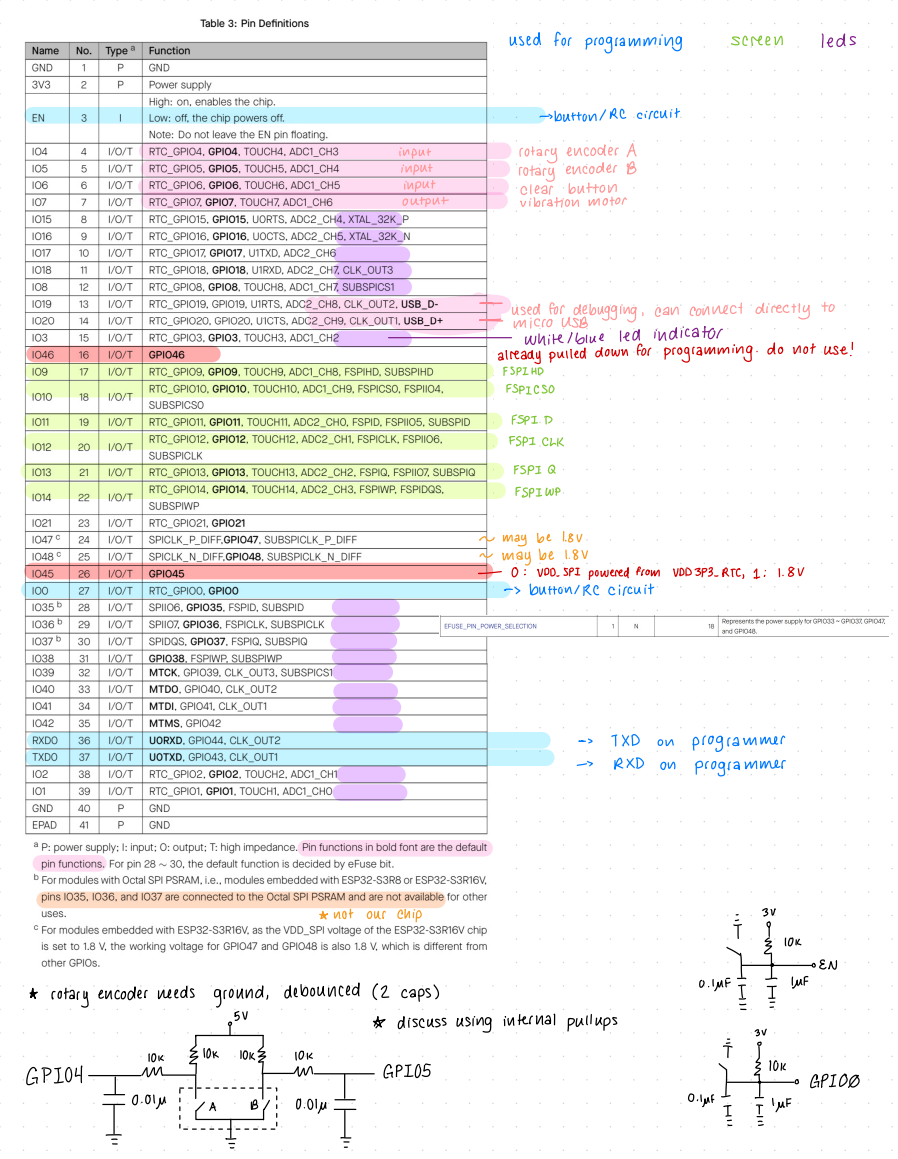
[picture p76: page 2]
input; rotary encoder A; rotary encoder B; clear; button; output; vibration motor; used for debugging ,; can connect directly to; FSPIHD; FSPICSO; FSPID; FSPICLK; FSPIQ; FSPIWP; may be 1.81; may be 1 .; VDD- SPI powered from; UDD3P3-RTC ,; button/RC circuit; TXD; programmer; RXD; * not our; chip; * rotary encoder needs; ground ,; debounced (2 caps); IMFMF .; * discuss using internal pullups; GPIO5; GPIOO; IMF

micro USB
white/blue led indicator
already pulled down for programming·

do not use !

* SP12 & | SP13 | are | general purpose, | of 1 | are | used by esp32

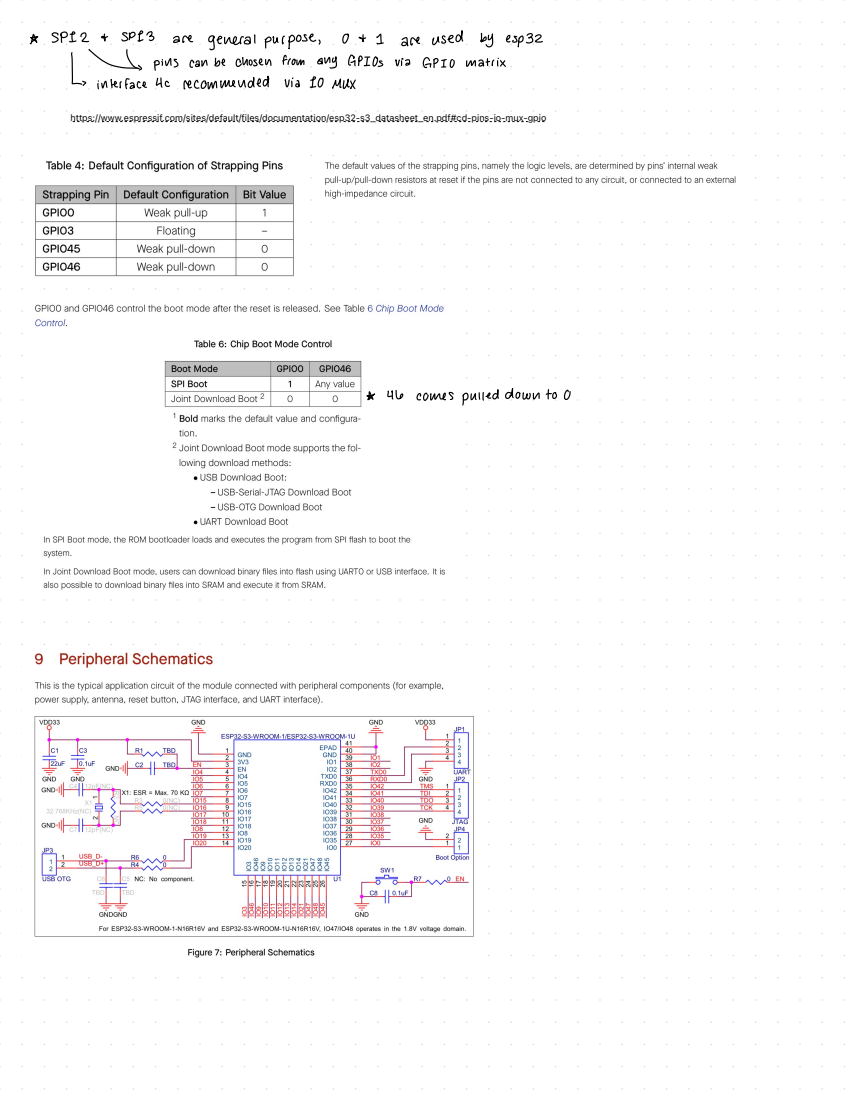
[picture p77: page 3]
↳&) pins can be chosen from any GPIOs via; GPIO matrix; interface 40; recommended via 10 Mux; comes pulled down too

https://www.espressif.com/sites/default/files/documentation/esp32-s3_datasheet_en.pdf#cd-pins-io-mux-gpio
