Kgo222/ClassroomClarity/notebooks/jesse/week_of_2_16_2025/445_WO_2_16_2025.pdf

https://www.amazon.com/DSD-TECH-Adapter-FT232RL-Compatible/dp/B07BBPX8B8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

2/19/2025

# Programmer

USCode | w/ | Platform 10 | extension
allows use | of Arduino platform
can use | ESP-IDF | who changing build platformer

## well documented

2/22/2025 | RXD TXB
I A Signal list | 1 EE 11

D D

O

EI

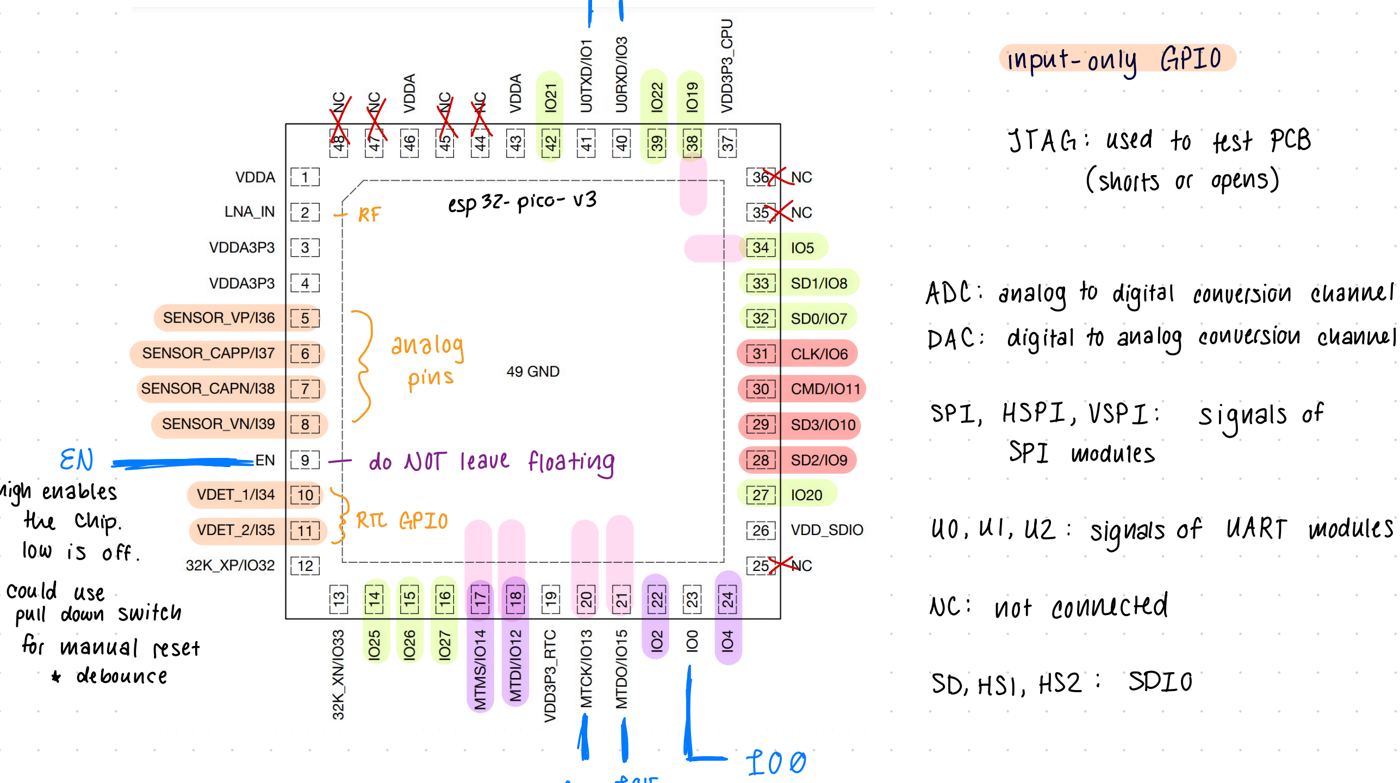
[picture p78: figure]
XXXX; JTAG :; used to test PCB; (shorts or; opens); esp32-pico-v3; SPI ,; HSPI ,; USP1 :; signals of; SPI modules do NOT leave -; floating; the chip.; 3RTC GPIO; signals of UART modules; low is off; could use; not connected pull down switch; for manual reset; debounce; HSI ,; SDIG 200

# input-only GPIO

ADC : | analog to digital conversion channel
DAC : | digital to analog conversion channel analog 3 pins

high enables

↳ | low enters | program mode
when | en | is | high , | Could also tie this For On | programmer :
CTS : | clear to | to | a | button | or | RTS send

# telling chip it's ready to receive

↑ | T | * | programs when | DTR = | 0 , | RIS = | 1 RiS : | request to send
programmer | programmer | = | EN = | 1 | 100 = | 0 asking chip to send data | can send | can | receive

# Notes :

DTR : | data | terminal ready
rotary encoder outputs digital | tells chip its | ready to send or | receive data

For programming ,

can | use | 4 pin header | or | 6 | pin header

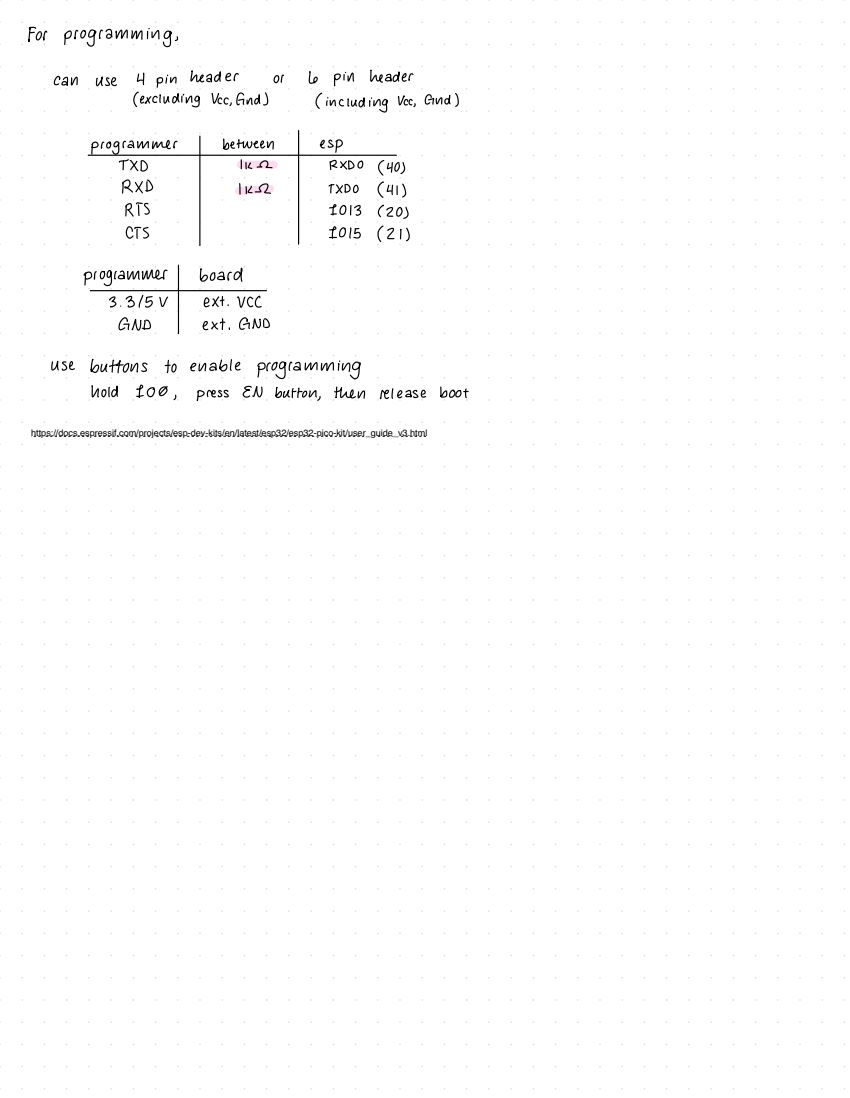
[picture p79: page 2]
(excluding Ve, Gnd); (including Vo,; Gnd); programmer; between; eso; RXDO; I TXDO; (41) I RTS; CTS; board; ext .; VCC; GND; use; buttons to enable; programming; hold; press EN button,; then release; boot

https://docs.espressif.com/projects/esp-dev-kits/en/latest/esp32/esp32-pico-kit/user_guide_v3.html
