Kgo222/ClassroomClarity/(commit log)

2025-02-26 Update README.md
    fixed incorrect new chip (ESP32-PICO-V3) to actual new chip (ESP32-S3-WROOM-1)
2025-02-26 added buttons - need to fix spacing
2025-02-28 Added text field, button need style fixing
